tlsystems/H10-Paper-Tape-Reader-Punch/Heathkit H10 Info/H10 Manuals/H10 Parallel Connector.jpg

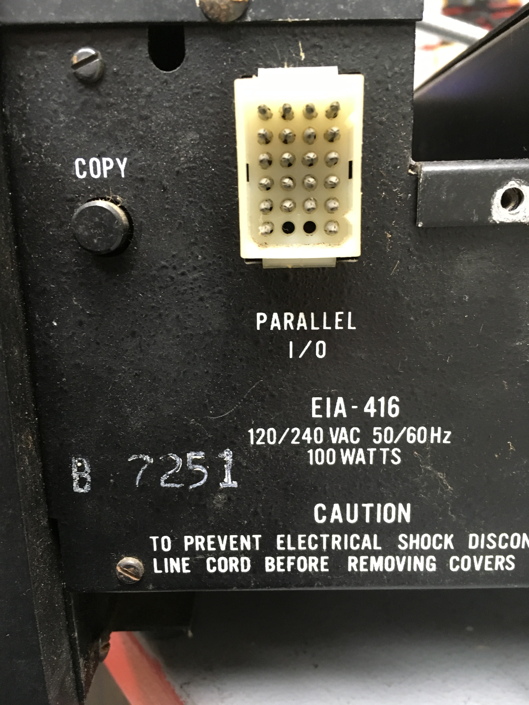
Heathkit H10 Info/H10 Manuals/H10 Parallel Connector.jpg
