tlsystems/H10-Paper-Tape-Reader-Punch/Heathkit H10 Info/H10 Manuals/H10 Schematic.pdf

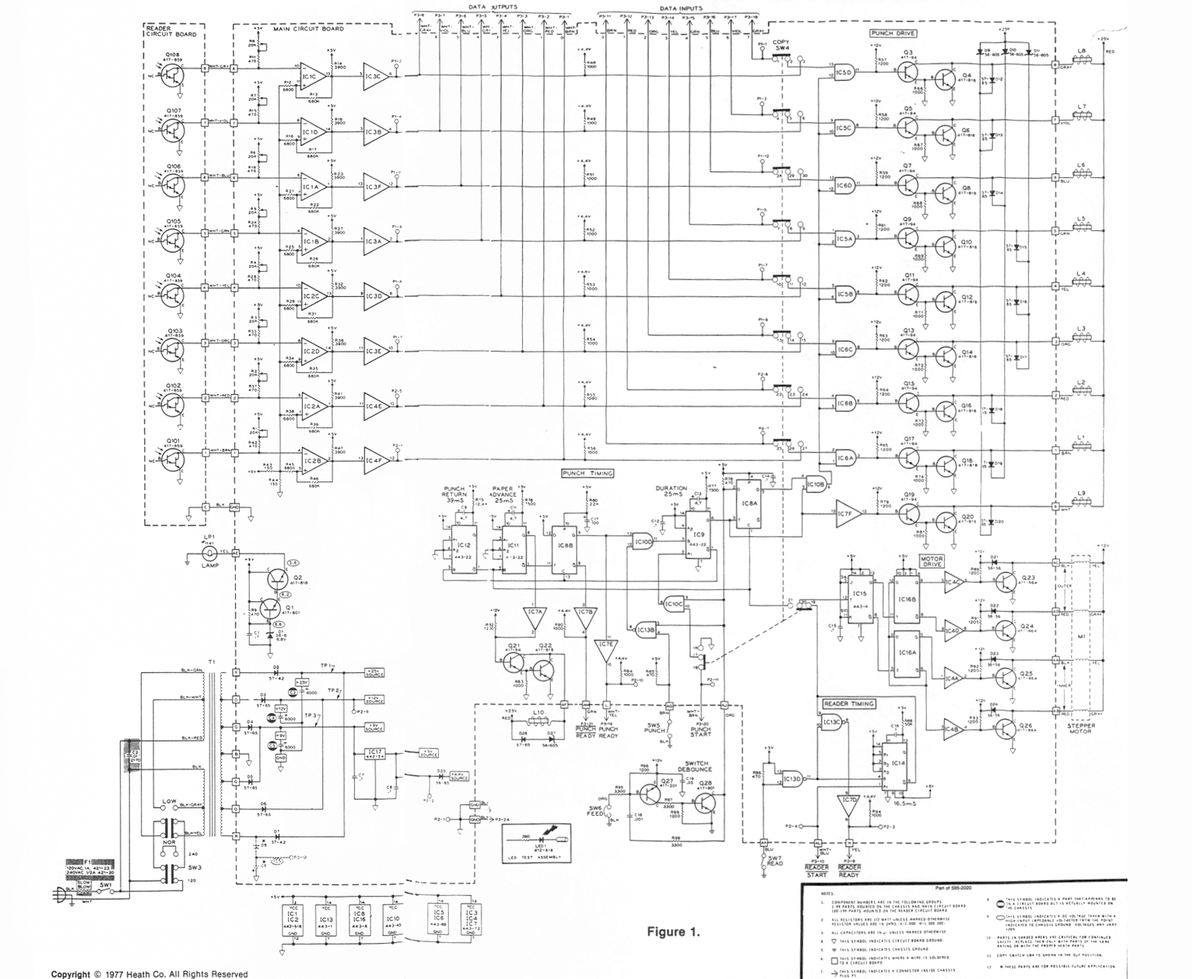
[picture p2: page 1]
