tlsystems/H10-Paper-Tape-Reader-Punch/H10 Info.xlsx

Sheet: Interface Specs
H10 Punch Inputs |  |  |  | 74HC595 Outputs @ 4.5V VCC |  | 74HCT595 Outputs @ 4.5V VCC
 | VIH | 2.0V min | <<<<< | VOH | 4.4V min | VOH | 3.98V min
 | VIL | 0.8V max | <<<<< | VOL | 0.33V max | VOL | 0.26V max
 | IIL | -1.6 mA | <<<<<
H10 Reader Outputs |  |  |  | SN74HC165 Inputs |  | SN74HCT165 Inputs |  |  | CD74HCT165 Inputs
 | VOH | 2.4V min | >>>>> | VIH | 3.15 min | VIH | 2.0V min | 1.6 typ | VIH | 2.0V min | 1.6 typ
 | VOL | 0.4V max | >>>>> | VIL | 1.35 max | VIL | 0.8V max | 1.2 typ | VIL | 0.8V max | 1.2 typ
 |  |  |  | IIL | 0.1uA | IIL | 1uA |  | IIL | 1uA
H10 Control Inputs
 | VIH | 2.0V min
 | VIL | 0.8V max
 | IIL | -1.6 mA
H10 Control Outputs
 | VOH† | +15V max
 | VOL | 0.4V max
 | IOL | 16mA
 | † | Open Collector w/1k pullup to 4.4V

Sheet: Commands
? | Help |  | Help Text | Return command help
EC | Echo | 0/1 | OK | Set serial port echo mode
PB | Punch Byt | 1 byte | OK | Punches on byte on H10
PT |  | String of characters | OK | Punches bitmapped text on the H10
PH |  | Intel hex record | OK | Punched data from an Intel Hex record
RB |  | <none> | 1 byte | Read one byte from the H10
RD |  | # bytes | Intel Hex Record | Reads 'n' bytes and returns them in a Intel Hex record

Sheet: CD vs. SN
SN74HCT165 Inputs |  |  | CD74HCT165 Inputs
VIH | 2.0V min | 1.6 typ | VIH | 2.0V min | 1.6 typ
VIL | 0.8V max | 1.2 typ | VIL | 0.8V max | 1.2 typ
IIL | 1uA |  | IIL | 1uA
VOH | 3.84V | 4mA | VOH | 3.98V | 4mA
VOL | 0.33V | 4mA | VOL | 0.33V | 4mA

Sheet: ICs
ICx | Type | Description
1 | LM2901 | Quad Differential Comparators
2 | LM2901 | Quad Differential Comparators
3 | SN74x17 | hex buffer gate w/open-collector
4 | SN74x17 | hex buffer gate w/open-collector
5 | SN74x09 | quad 2-input AND gate w/open-collector
6 | SN74x09 | quad 2-input AND gate w/open-collector
7 | SN74x17 | hex buffer gate w/open-collector
8 | SN74x74 | dual D positive edge triggered flip-flop, asynchronous preset and clear
9 | SN74x121 | monostable multivibrator w/Schmitt-trigger
10 | SN74x08 | quad 2-input AND gate
11 | SN74x121 | monostable multivibrator w/Schmitt-trigger
12 | SN74x121 | monostable multivibrator w/Schmitt-trigger
13 | SN74x00 | quad 2-input NAND gate
14 | 9600 | one-shot
15 | SN74x72 | AND gated J-K master-slave flip-flop, asynchronous preset and clear
16 | SN74x74 | dual D positive edge triggered flip-flop, asynchronous preset and clear

Sheet: TIming
PunchStart# | 200nS Min 80mS Max
PunchReady# | 200nS Max
PunchData
 |  | 25mSec Min
ReaderStart# | 100nS min
ReaderReady# | 200ns Max
Reader Data

Sheet: DB9
DB-9 RS-232 Wiring
 |  |  |  |  | View from front of connector
DB9-F | 10-pinFlat
1 | 1
2 | 3
3 | 5
4 | 7
5 | 9
6 | 2
7 | 4
8 | 6
9 | 8
 | 10
Out | DCD (1) | 1 | 2 | DSR (6) | Out
 | TxD (2) | 3 | 4 | CTS (7)
 | RxD (3) | 5 | 6 | RTS (8)
In | DTR (4) | 7 | 8 | RI (9) | Out |  |  | DB9-F | DB9-M
 | GND (5) | 9 | 10 | nc |  |  |  | DTE | DCE
 |  |  |  |  |  | 1 | DCD | In | Out | Data Carrier Detect
 |  |  |  |  |  | 2 | Rx | In | Out | Receive Data
 |  |  |  |  |  | 3 | Tx | Out | In | Transmit Data
 |  |  |  |  |  | 4 | DTR | Out | In | Data Terminal Ready
 |  |  |  |  |  | 5 | GND
 |  |  |  |  |  | 6 | DSR | In | Out | Data Set Ready
 |  |  |  |  |  | 7 | RTS | Out | In | Request To Send
 |  |  |  |  |  | 8 | CTS | In | Out | Clear To Send
 |  |  |  |  |  | 9 | RI | In | Out | Ring Indicator

Sheet: Transition Cable
H10 Transistion Cable Wiring
24-pin Molex to DB-25
 | P3 4x6 Molex | 2x13 Header | Color Internal | SW4 Pin | Function | Color | DB-25 | Wire # | Function | Color External | 24-Pin Molex |  |  |  | Wire | DB25 |  |  |  |  |  | SW4
 | 1 | 3 | Wh/Brn | 27 | RDO-0 | Grn | 1 | 1 | RDO-0 | Rd
 | 2 | 4 | Wh/Red | 24 | RDO-1 | Grn | 14 | 2 | RDO-1 | Wh/Bk/Rd |  |  |  |  | 1 | 1 | 1 |  |  | RD-0
 | 3 | 5 | Wh/Org | 15 | RDO-2 | Grn | 2 | 3 | RDO-2 | Wh/Gy |  |  |  |  | 2 |  |  | 14 | 2 | RD-1
 | 4 | 6 | Wh/Yel | 12 | RDO-3 | Grn | 15 | 4 | RDO-3 | Wh/Br |  |  |  |  | 3 | 3 | 2 |  |  | RD-2
 | 5 | 7 | Wh/Grn | 9 | RDO-4 | Grn | 3 | 5 | RDO-4 | Wh |  |  |  |  | 4 |  |  | 15 | 4 | RD-3 |  | Back
 | 6 | 8 | Wh/Blu | 30 | RDO-5 | Grn | 16 | 6 | RDO-5 | Gr | 4 | 3 | 2 | 1 | 5 | 5 | 3 |  |  | RD-4
 | 7 | 9 | Wh/Vio | 6 | RDO-6 | Grn | 4 | 7 | RDO-6 | Wh/Vi |  |  |  |  | 6 |  |  | 16 | 6 | RD-5 | 20 | Wh/Brn/Bk | 16 | 1 | Gry | 18
 | 8 | 10 | Wh/Gry | 3 | RDO-7 | Grn | 17 | 8 | RDO-7 | Rd/Yl | 8 | 7 | 6 | 5 | 7 | 7 | 4 |  |  | RD-6 |  |  | 17 | 2 | --7--
 | 9 | 21 | Yel | nc | ~ReaderReady | Blu | 10 | 19 | ~ReaderReady | Wh/Or |  |  |  |  | 8 |  |  | 17 | 8 | RD-7 |  |  | 18 | 3 | Wh/Gry | 8
 | 10 | 24 | Wh/Blu | nc | ~ReaderStart | Yel | 23 | 20 | ~ReaderStart | Gy | 12 | 11 | 10 | 9 | 9 | 22a | 5 |  |  | GND |  |  | 19 | 4 | Vio | 17
 | 11 | 12 | Brn | 25 | PDI-0 | Wh | 18 | 10 | PDI-0 | Gr/Rd |  |  |  |  | 10 |  |  | 18 | 11 | PD-0 |  |  | 20 | 5 | --6--
 | 12 | 13 | Red | 22 | PDI-1 | Wh | 6 | 11 | PDI-1 | Wh/Bl | 16 | 15 | 14 | 13 | 11 | 12 | 6 |  |  | PD-1 |  |  | 21 | 6 | Wh/Vio | 7
 | 13 | 14 | Org | 13 | PDI-2 | Wh | 19 | 12 | PDI-2 | Vi |  |  |  |  | 12 |  |  | 19 | 13 | PD-2 | 12 | Red | 22 | 7 | Grn | 15
 | 14 | 15 | Yel | 10 | PDI-3 | Wh | 7 | 13 | PDI-3 | Yl | 20 | 19 | 18 | 17 | 13 | 14 | 7 |  |  | PD-3 |  | --1-- | 23 | 8 | --4-
 | 15 | 16 | Grn | 7 | PDI-4 | Wh | 20 | 14 | PDI-4 | Wh/Bk |  |  |  |  | 14 |  |  | 20 | 15 | PD-4 | 2 | Wh/Red | 24 | 9 | Wh/Grn | 5
 | 16 | 17 | Blu | 28 | PDI-5 | Wh | 8 | 15 | PDI-5 | Wh/Rd | 24 | 23 | 22 | 21 | 15 | 16 | 8 |  |  | PD-5 | 11 | Brown | 25 | 10 | Yel | 14
 | 17 | 18 | Vio | 4 | PDI-6 | Wh | 21 | 16 | PDI-6 | Pk |  |  |  |  | 16 |  |  | 21 | 17 | PD-6 |  | --0-- | 26 | 11 | --3--
 | 18 | 19 | Gry | 1 | PDI-7 | Wh | 9 | 17 | PDI-7 | Bl |  |  |  |  | 17 | 18 | 9 |  |  | PD-7 | 1 | Wh/Brn | 27 | 12 | Wh/Yel | 4
 | 19 | NC | Grn | nc | PunchReady | Blu | 12 | 23 | ~PunchReady | Wh/Gr |  |  |  |  | 18 |  |  | 22 | 22b | GND | 16 | Blue | 28 | 13 | Org | 13
 | 20 | 25 | Wh/Brn/Blk | 16 | PunchStart | Yel | 24 | 22 | ~PunchStart | Tan |  |  |  |  | 19 | 9 | 10 |  |  | ~ReaderReady |  | --5-- | 29 | 14 | --2--
 | 21 | 22 | Wh/Brn/Blk | 16 | ~PunchReady | Yel | 24 | 22 | ~PunchStart | Tan |  |  |  |  | 20 |  |  | 23 | 10 | ~ReaderStart | 6 | Wh/Blu | 30 | 15 | Wh/Org | 3
 | 22 | 11 | Blk | nc | GND | Blk | 11,25 | 21,24 | GND |  |  |  |  |  | 21 | 24a | 11 |  |  | GND
 | 23 | 1 | Red (New) | nc | +9V | Red | 13 | 25 | +12V | Wh/Yl |  |  |  |  | 23 | 21 | 12 |  |  | ~PunchReady
 | 24 | 2 | Blk | nc | GND | Blk | 11,25 | 21,24 | GND |  |  |  |  |  | 25 | 23a | 13 |  |  | +12V
 |  | 20 | Blk | nc | GND | Blk | 11,25 | 21,24 | GND |  |  |  |  |  | 25 | 23a | 13 |  |  | +12V | 9 | Yellow
 |  | 23 | Blk (New) | nc | GND | Blk | 5,22 | 9,18 | GND | Or |  |  |  |  | 26 |  |  |  |  | N/C | 10 | White/Blue
 |  | 26 | NC |  |  |  |  |  |  |  |  |  |  |  |  |  |  |  |  |  | 19 | White/Yello
 |  |  |  |  |  |  |  |  |  |  |  |  |  |  |  |  |  |  |  |  | 21 | Green
 |  |  |  |  |  |  |  |  |  |  |  |  |  |  |  |  |  |  |  |  | 22 | BK
 |  |  |  |  |  |  |  |  |  |  |  |  |  |  |  |  |  |  |  |  | 23 | RD
 | 21 |  | Wh/Yel | nc | PunchReady |  |  |  |  | Rd/Bk |  |  |  |  |  |  |  |  |  |  | 24 | BK
 | 1 |  | +12V
 | 2 |  | GND |  |  |  |  | 1 | White/Brown
 | 3 |  | RD0 | Output |  |  |  | 2 | White/Red
 | 4 |  | RD1 | Output |  |  |  | 3 | Whitw/Orange
 | 5 |  | RD2 | Output |  |  |  | 4 | White/Yellow
 | 6 |  | RD3 | Output |  |  |  | 5 | White/Green
 | 7 |  | RD4 | Output |  |  |  | 6 | White/Blue
 | 8 |  | RD5 | Output |  |  |  | 7 | White/Purple
 | 9 |  | RD6 | Output |  |  |  | 8 | White/Grey
 | 10 |  | RD7 | Output |  |  |  | 9 | Yellow
 | 11 |  | GND |  |  |  |  | 10 | White/Blue
 | 12 |  | PD0 | Input |  |  |  | 11 | Brown
 | 13 |  | PD1 | Input |  |  |  | 12 | Red
 | 14 |  | PD2 | Input |  |  |  | 13 | Orange
 | 15 |  | PD3 | Input |  |  |  | 14 | Yellow
 | 16 |  | PD4 | Input |  |  |  | 15 | Green
 | 17 |  | PD5 | Input |  |  |  | 16 | Blue
 | 18 |  | PD6 | Input |  |  |  | 17 | Purple
 | 19 |  | PD7 | Input |  |  |  | 18 | Grey
 | 20 |  | GND |  |  |  |  | 19 | White/Yellow
 | 21 |  | ReaderReady# | Output |  |  |  | 20 | White/Browh
 | 22 |  | PunchReady# | Output |  |  |  | 21 | Green
 | 23 |  | GND |  |  |  |  | 22 | Black
 | 24 |  | ReaderStart# | Input |  |  |  | 23 | Red
 | 25 |  | PunchStart# | Input |  |  |  | 24 | Black
 | 26
 | DB-25 | Cable | Name | Color
 | 1 | 1 | RDO-0 | Gn
 | 14 | 2 | RDO-1 | Gn
 | 2 | 3 | RDO-2 | Gn
 | 15 | 4 | RDO-3 | Gn
 | 3 | 5 | RDO-4 | Gn
 | 16 | 6 | RDO-5 | Gn
 | 4 | 7 | RDO-6 | Gn
 | 17 | 8 | RDO-7 | Gn
 | 5 | 9 | GND | Bk
 | 18 | 10 | PDI-0 | Wh
 | 6 | 11 | PDI-1 | Wh
 | 19 | 12 | PDI-2 | Wh
 | 7 | 13 | PDI-3 | Wh
 | 20 | 14 | PDI-4 | Wh
 | 8 | 15 | PDI-5 | Wh
 | 21 | 16 | PDI-6 | Wh
 | 9 | 17 | PDI-7 | Wh
 | 22 | 18 | GND | Bk
 | 10 | 19 | ~ReaderReady | Bl
 | 23 | 20 | ~ReaderStart | Yl
 | 11 | 21 | GND | Bk
 | 24 | 22 | ~PunchStart | Yl
 | 12 | 23 | ~PunchReady | Bl
 | 25 | 24 | GND | Bk
 | 13 | 25 | +12V | Rd
 | NC | 26

Sheet: Shield Wiring
 | V 0.3 | Wiz Shield | V 0.4 |  |  |  |  |  |  |  | Teensy 4.0 | Teensy 4.1
SCK
SDA
GND
AREF
D13
D12 |  |  | PunchStart |  | GND | 1
D11 | PunchStart |  | PunchReady | ISCP GND | GND | 2 | 1 | 3V3D | 3V3 | CS | 10 | 10
D10 | PunchReady | CSn |  | ISCP MOSI | MOSI | 3 | 2 | RDY | D2 | MOSI | 11 | 11
D9 | ReaderReady |  | ReaderReady | ISCP MISO | MISO | 4 | 3 | RSTn | D3 | MISO | 12 | 12
D8 | ReaderStart |  | ReaderStart | ISCP SCLK | SCLK | 5 | 4 | NC |  | SCK | 13 | 13
D7 | ReadDataLoad |  | ReadDataLoad | D10 | SCSn | 6 | 5 | INTn | D5 | RDY |  | 31
D6 | PunchDataLatch |  | PunchDataLatch |  | 3V3D | 7 | 6 | GND | GND | RSTn |  | 30
D5 |  | INTn (2-7) |  |  | 3V3D | 8 |  |  |  | INTn | 5 | 29
D4 |  | SD_SSn (8-10) |  |  |  |  |  |  |  | SC_SSn | 4 | 33
D3 | CTS |  | CTS
D2 | RTS |  | RTS |  |  |  |  |  |  | LED1
D1 | Tx |  | Tx |  | GND | 6 | 5 | RESET
D0 | Rx |  | Rx |  | MOSI | 4 | 3 | SCK | RD
 |  |  |  |  | 5V | 2 | 1 | MISO | OR
ICSP-GND | GND | GND | GND
ICSP-Vcc | Vcc | Vcc | Vcc
ICSP-RSTn
ICSP-SCK | SCK | SCK | SCK |  |  |  |  |  |  | SCK | 13
ISCP-MOSI | MOSI | MOSI | MOSI |  |  |  |  |  |  | MOSI | 11
ISCP-MISO | MISO | MISO | MISO |  |  |  |  |  |  | MISO | 12
A0 | LED1 |  | LED1
A1 | LED2 |  | LED2
A2
A3
A4
A5
A6
 | W5100 | W5200 | W5500
 |  | writeMR(0x08) | writeMR(0x08)
 |  | writeMR(0x10) | writeMR(0x10)
 |  | writeMR(0x00) | writeMR(0x00)
 |  | Version = 3 | Version = 4

Sheet: Sheet2
 |  |  |  |  |  |  | Row
 | 0x00 | 0x00 | 0x5f | 0x00 | 0x00 |  | 7 | 6 | 5 | 4 | 3 | 2 | 1 | 0
 |  |  |  |  |  | Col 0 |  | . | . | . | . | . | . | . | 0x00 |  | 0,0- | 0,0
00000000 | row0 | 0x00 |  |  |  | Col 1 |  | . | . | . | . | . | . | . | 0x00 |  | 0,1 | 1,0
00000000 | row1 | 0x04 |  |  |  | Col 2 |  | x |  | x | x | x | x | x | 0x5f |  | 0,2 | 2,0
01011111 | row2 | 0x00 |  |  |  | Col 3 |  | . | . | . | . | . | . | . | 0x00 |  | 0,3 | 3,0
00000000 | row3 | 0x04 |  |  |  | Col 4 |  | . | . | . | . | . | . | . | 0x00 |  | 0,4 | 4,0
00000000 | row4 | 0x04 |  |  |  | Col 5
 | row5 | 0x04 |  |  |  | Col 6
 | row6 | 0x04 |  |  |  | Col 7 |  |  |  |  |  |  |  |  |  |  | 2,0 | 0,2
 | row7 | 0x04 |  |  |  |  |  |  |  |  |  |  |  |  |  |  | 2,1 | 1,2
 |  |  |  |  |  |  | Col |  |  |  |  |  |  |  |  |  | 2,2 | 2,2
 |  |  |  |  |  |  | 7 | 6 | 5 | 4 | 3 | 2 | 1 | 0 |  |  | 2,3 | 3,2
 |  |  |  |  |  | Row 0 |  |  |  | . | . | x | . | . | 0x04 |  | 2,4 | 4,2
 |  |  |  |  |  | Row 1 |  |  |  | . | . | x | . | . | 0x04 |  | 2,5 | 5,2
 |  |  |  |  |  | Row 2 |  |  |  | . | . | x | . | . | 0x04 |  | 2,6 | 6,2
 |  |  |  |  |  | Row 3 |  |  |  | . | . | x | . | . | 0x04 |  | 2,7 | 7,2
 |  |  |  |  |  | Row 4 |  |  |  | . | . | x | . | . | 0x04
 |  |  |  |  |  | Row 5 |  |  |  | . | . | . | . | . | 0x04
 |  |  |  |  |  | Row 6 |  |  |  | . | . | x | . | . | 0x04
 |  |  |  |  |  | Row 7
 |  |  |  |  |  |  | 0 | 1 | 2 | 3 | 4 | 5 | 6 | 7
 |  |  |  |  |  | Col 0 | . | . | x | . | . |  |  |  | 0x04
 |  |  |  |  |  | Col 1 | . | x | x | . | . |  |  |  | 0x06
 |  |  |  |  |  | Col 2 | . | . | x | . | . |  |  |  | 0x04
 |  |  |  |  |  | Col 3 | . | . | x | . | . |  |  |  | 0x04
 |  |  |  |  |  | Col 4 | . | . | x | . | . |  |  |  | 0x04
 |  |  |  |  |  | Col 5 | . | . | x | . | . |  |  |  | 0x04
 |  |  |  |  |  | Col 6 | . | x | x | x | . |  |  |  | 0x0e
 |  |  |  |  |  | Col 7
 |  |  |  |  |  |  | Col
 |  |  |  |  |  |  | 0 | 1 | 2 | 3 | 4 | 5 | 6 | 7 |  | 0,0 | 0,0
 |  |  |  |  |  | Row 0 | . | . | . | . | . | . | . |  | 0x04 | 0,1 | 1,0
 |  |  |  |  |  | Row 1 | . | x | . | . | . | . | x |  | 0x04 | 0,2 | 2,0
 |  |  |  |  |  | Row 2 | x | x | x | x | x | x | x |  | 0x04
 |  |  |  |  |  | Row 3 | . | . | . | . | . | . | x |  | 0x04
 |  |  |  |  |  | Row 4 | . | . | . | . | . | . | . |  | 0x04
 |  |  |  |  |  | Row 5 |  |  |  |  |  |  |  |  | 0x04
 |  |  |  |  |  | Row 6 |  |  |  |  |  |  |  |  | 0x04
 |  |  |  |  |  | Row 7
 |  |  |  | a5 | 10100101

Sheet: Sheet3
 |  |  |  |  |  |  |  | 48 | $J$52 | $K$52 | $L$52 | $M$52 | $N$52 | $O$52
 |  |  |  |  |  |  |  |  | 00000000 | 00111110 | 01010001 | 01001001 | 01000101 | 00111110
 |  |  |  |  |  |  |  |  | Col 0 | Col 1 | Col 2 | Col 3 | Col 4 | Col 5 |  |  |  |  |  |  | byte [][] CharMap = {
0 | 0x0 | # | 0x00 | 0x00 | 0x00 | 0x00 | 0x00 | NUL | 0 | 0 | 0 | 0 | 0 | 0 | 8 |  | . | . | . |  | {0x00,0x00,0x00,0x00,0x00}, // 0x0 '#'
1 | 0x1 | SOH | 0x00 | 0x00 | 0x00 | 0x00 | 0x00 | Smile | 0 | 0 | 0 | 0 | 0 | 0 | 7 | . |  |  |  | . | {0x00,0x00,0x00,0x00,0x00}, // 0x1 'SOH'
2 | 0x2 | STC | 0x00 | 0x00 | 0x00 | 0x00 | 0x00 | Smile | 0 | 0 | 0 | 0 | 0 | 0 | 6 | . |  |  | . | . | {0x00,0x00,0x00,0x00,0x00}, // 0x2 'STC'
3 | 0x3 | ETX | 0x00 | 0x00 | 0x00 | 0x00 | 0x00 | Heart | 0 | 0 | 0 | 0 | 0 | 0 | 5 | . |  | . |  | . | {0x00,0x00,0x00,0x00,0x00}, // 0x3 'ETX'
4 | 0x4 | EOT | 0x00 | 0x00 | 0x00 | 0x00 | 0x00 | Diamond | 0 | 0 | 0 | 0 | 0 | 0 | 4 | . | . |  |  | . | {0x00,0x00,0x00,0x00,0x00}, // 0x4 'EOT'
5 | 0x5 | ENQ | 0x00 | 0x00 | 0x00 | 0x00 | 0x00 | Club | 0 | 0 | 0 | 0 | 0 | 0 | 3 | . |  |  |  | . | {0x00,0x00,0x00,0x00,0x00}, // 0x5 'ENQ'
6 | 0x6 | ACK | 0x00 | 0x00 | 0x00 | 0x00 | 0x00 | Spade | 0 | 0 | 0 | 0 | 0 | 0 | 2 |  | . | . | . |  | {0x00,0x00,0x00,0x00,0x00}, // 0x6 'ACK'
7 | 0x7 | BEL | 0x00 | 0x00 | 0x00 | 0x00 | 0x00 | Bullet1 | 0 | 0 | 0 | 0 | 0 | 0 | 1 |  |  |  |  |  | {0x00,0x00,0x00,0x00,0x00}, // 0x7 'BEL'
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
127 | 0x7F |  | 0x7f | 0x6b | 0x6b | 0x6b | 0x7f |  | 0 | 1111111 | 1101011 | 1101011 | 1101011 | 1111111 |  |  |  |  |  |  | {0x7f,0x6b,0x6b,0x6b,0x7f}, // 0x7F ' '
 |  |  |  |  |  |  |  |  |  |  |  |  |  |  |  |  |  |  |  |  | };
