tlsystems/H10-Paper-Tape-Reader-Punch/Kicad/H10 Pi Pico/H10 Pico Info.xlsx

Sheet: RedBoard T
seq | Connector | Function | Signal | Pin | Pin Function | Dir | I/O Pin | Supply | EIC | REF | ADC | AC | PTC | DAC | SER | ALT | TC/TCC | TCC | COM | AC/GCLK | Other
 |  | Reset | RESET~
 | J1-1 | Power Battery | VBAT
 | J1-2 | Power | GND
 | J2-1 | Power | GND
 | J2-2 | Power | VCC
38 | J2-3 | QWIIC | SDA | 31 | SERCOM3:1 |  | PA22 | VDDIO | EXTINT[6] |  |  |  | X[10] |  | SERCOM3:0 | SERCOM5:0 | TC4:0 | TCC0:4 |  | GCLK_IO[6]
38 | J2-4 | QWIIC | SCL | 32 | SERCOM3:0 |  | PA23 | VDDIO | EXTINT[7] |  |  |  | X[11] |  | SERCOM3:1 | SERCOM5:1 | TC4:1 | TCC0:5 | USB/SOF 1kHz | GCLK_IO[7]
 | J3-1 | VBUS | VUSB
39 | J3-2 | D- | USB_D- | 33 | USB_DM |  | PA24(6) | VDDIO | EXTINT[12] |  |  |  |  |  | SERCOM3:2 | SERCOM5:2 | TC5:0 | TCC1:2 | USB/DM
40 | J3-3 | D+ | USB_D+ | 34 | USB_DP |  | PA25(6) | VDDIO | EXTINT[13] |  |  |  |  |  | SERCOM3:3 | SERCOM5:3 | TC5:1 | TCC1:3 | USB/DP
 | J3-4 | ID | USB_ID
 | J3-5 | GND | GND
 | J3-6 | SHIELD | SHIELD
 | JP1-Sleeve | Power External | GND
 | JP1-Tip | Power External | ExtPower
 | JP6-01 | VCC | 3V3
 | JP6-02 | SWDIO/TMD | RX_LED/SWDIO
 | JP6-03 | GND | GND
 | JP6-04 | SWDCLK/TCK | LED/SWCLK
 | JP6-05 | GND | GND
 | JP6-06 | SWO/TDO | NC
 | JP6-07 | KEY | NC
 | JP6-08 | NC/TDI | NC
 | JP6-09 | GNDDTCT | NC
 | JP6-10 | NRESET | RESET~
 | TP1 |  | RX_LED/SWDIO
 | Shld1-01 | IO QWIIC | SCL | 32 | SERCOM3:1 |  | PA23 | VDDIO | EXTINT[7] |  |  |  | X[11] |  | SERCOM3:1 | SERCOM5:1 | TC4:1 | TCC0:5 | USB/SOF 1kHz | GCLK_IO[7]
 | Shld1-02 | IO QWIIC | SDA | 31 | SERCOM3:0 |  | PA22 | VDDIO | EXTINT[6] |  |  |  | X[10] |  | SERCOM3:0 | SERCOM5:0 | TC4:0 | TCC0:4 |  | GCLK_IO[6]
8 | Shld1-03 | IO Analog | AREF | 4 | ADC/VREFA/DAC/VREFA |  | PA03 | VDDANA | EXTINT[3] | ADC/VREFA/DAC/VREFA | AIN[1] |  | Y[1] |  |  |  |  | TCC3:1
 | Shld1-04 | Power | GND
32 | Shld1-05 | IO Digital | D13 ~ | 26 | PA17 | DIO | PA17 | VDDIO | EXTINT[1] |  |  |  | X[5] |  | SERCOM1:1 | SERCOM3:1 | TCC2:1 | TCC0:7 |  | GCLK_IO[3]
34 | Shld1-06 | IO Digital | D12 ~ | 28 | PA19 | DIO | PA19 | VDDIO | EXTINT[3] |  |  |  | X[7] |  | SERCOM1:3 | SERCOM3:3 | TC3:1 | TCC0:3 | I2S/SD[0] | AC/CMP[1]
31 | Shld1-07 | IO Digital | D11 ~ | 25 | PA16 | DIO | PA16 | VDDIO | EXTINT[0] |  |  |  | X[4] |  | SERCOM1:0 | SERCOM3:0 | TCC2:0 | TCC0:6 |  | GCLK_IO[2]
33 | Shld1-08 | IO Digital | D10 ~ | 27 | PA18 | DIO | PA18 | VDDIO | EXTINT[2] |  |  |  | X[6] |  | SERCOM1:2 | SERCOM3:2 | TC3:0 | TCC0:2 |  | AC/CMP[0]
12 | Shld1-09 | IO Digital | D9 ~ | 12 | PA07 | DIO | PA07 | VDDANA | EXTINT[7] |  | AIN[7] | AIN[3] | Y[5] |  |  | SERCOM0:3 | TCC1:1 | TCC3:5 | I2S/SD[0]
11 | Shld1-10 | IO Digital | D8 ~ | 11 | PA06 | DIO | PA06 | VDDANA | EXTINT[6] |  | AIN[6] | AIN[2] | Y[4] |  |  | SERCOM0:2 | TCC1:0 | TCC3:4
36 | Shld2-1 | IO Digital | D7 | 30 | PA21 | DIO | PA21 | VDDIO | EXTINT[5] |  |  |  | X[9] |  | SERCOM5:3 | SERCOM3:3 | TC7:1 | TCC0:7 | I2S/FS[0] | GCLK_IO[5]
35 | Shld2-2 | IO Digital | D6 ~ | 29 | PA20 | DIO | PA20 | VDDIO | EXTINT[4] |  |  |  | X[8] |  | SERCOM5:2 | SERCOM3:2 | TC7:0 | TCC0:6 | I2S/SCK[0] | GCLK_IO[4]
30 | Shld2-3 | IO Digital | D5 ~ | 24 | PA15 | DIO | PA15 | VDDIO | EXTINT[15] |  |  |  |  |  | SERCOM2:3 | SERCOM4:3 | TC3:1 | TCC0:5 |  | GCLK_IO[1]
23 | Shld2-4 | IO Digital | D4 ~ | 13 | PA08 | DIO | PA08 | VDDIO | NMI |  | AIN[16] |  | X[0] |  | SERCOM0:0 | SERCOM2:0 | TCC0:0 | TCC1:2 | I2S/SD[1]
24 | Shld2-5 | IO Digital | D3 ~ | 14 | PA09 | DIO | PA09 | VDDIO | EXTINT[9] |  | AIN[17] |  | X[1] |  | SERCOM0:1 | SERCOM2:1 | TCC0:1 | TCC1:3 | I2S/MCK[0]
29 | Shld2-6 | IO Digital | D2 | 23 | PA14 | DIO | PA14 | VDDIO | EXTINT[14] |  |  |  |  |  | SERCOM2:2 | SERCOM4:2 | TC3:0 | TCC0:4 |  | GCLK_IO[0]
25 | Shld2-7 | IO Digital | D1/TX0 | 15 | PA10,SER0:2 |  | PA10 | VDDIO | EXTINT[10] |  | AIN[18] |  | X[2] |  | SERCOM0:2 | SERCOM2:2 | TCC1:0 | TCC0:2 | I2S/SCK[0] | GCLK_IO[4]
26 | Shld2-8 | IO Digital | DO/RXI | 16 | PA11,SER0:3 |  | PA11 | VDDIO | EXTINT[11] |  | AIN[19] |  | X[3] |  | SERCOM0:3 | SERCOM2:3 | TCC1:1 | TCC0:3 | I2S/FS[0] | GCLK_IO[5]
7 | Shld3-1 | IO Analog | A0/DAC | 3 | AIN[0], PA02, VOUT | AIN, DIO, AOUT | PA02 | VDDANA | EXTINT[2] |  | AIN[0] |  | Y[0] | VOUT |  |  |  | TCC3:0
15 | Shld3-2 | IO Analog | A1 | 7 | AIN[2], PA08 | AIN, DIO | PB08 | VDDANA | EXTINT[8] |  | AIN[2] |  | Y[14] |  |  | SERCOM4:0 | TC4:0 | TCC3:6
16 | Shld3-3 | IO Analog | A2 | 8 | AIN[3], PA09 | AIN, DIO | PB09 | VDDANA | EXTINT[9] |  | AIN[3] |  | Y[15] |  |  | SERCOM4:1 | TC4:1 | TCC3:7
9 | Shld3-4 | IO Analog | A3 | 9 | AIN[4], PA04 | AIN, DIO | PA04 | VDDANA | EXTINT[4] | ADC/VREFB | AIN[4] | AIN[0] | Y[2] |  |  | SERCOM0:0 | TCC0:0 | TCC3:2
10 | Shld3-5 | IO Analog | A4 | 10 | AIN[5], PA05 | AIN, DIO | PA05 | VDDANA | EXTINT[5] |  | AIN[5] | AIN[1] | Y[3] |  |  | SERCOM0:1 | TCC0:1 | TCC3:3
13 | Shld3-6 | IO Analog | A5 | 47 | AIN[10], PB02 | AIN, DIO | PB02 | VDDANA | EXTINT[2] |  | AIN[10] |  | Y[8] |  |  | SERCOM5:0 | TC6:0 | TCC3:2
 | Shld4-1 |  | REF
 | Shld4-2 | Power | 3V3
 | Shld4-3 | Power | 5V
 | Shld4-4 | Power | GND
 | Shld4-5 | Power | GND
 | Shld4-6 | Power External | VIN
1 |  |  | ???? | 40 | RESET~ |  | RESET~
2 |  |  | 3V3 | 44 | Power |  | VDDIN
3 |  |  | Bypass | 43 | Power |  | VDDCORE
4 |  |  | Filter | 6 | Power |  | VDDANA
5 |  | RTC | RTC XTAL | 1 | XIN32 |  | PA00 | VDDANA | EXTINT[0] |  |  |  |  |  |  | SERCOM1:0 | TCC2:0 |  |  |  | XIN32
6 |  | RTC | RTC XTAL | 2 | XOUT32 |  | PA01 | VDDANA | EXTINT[1] |  |  |  |  |  |  | SERCOM1:1 | TCC2:1 |  |  |  | XOUT32
14 |  | Flash Memory | FLASH_MISO | 48 | SERCOM5:1 |  | PB03 | VDDANA | EXTINT[3] |  | AIN[11] |  | Y[9] |  |  | SERCOM5:1 | TC6:1 | TCC3:3
17 |  |  | GND | 5 | Power |  | GNDANA
18 |  |  | GND | 18 | Power |  | GND
19 |  |  | GND | 35 | Power |  | GND
20 |  |  | GND | 42 | Power |  | GND
21 |  |  | 3V3 | 17 | Power |  | VDDIO
22 |  |  | 3V3 | 36 | Power |  | VDDIO
27 |  | SPI | SPI_MISO | 21 | SER4:0 |  | PA12 | VDDIO | EXTINT[12] |  |  |  |  |  | SERCOM2:0 | SERCOM4:0 | TCC2:0 | TCC0:6 |  | AC/CMP[0]
28 |  | Flash Memory | FLASH_CS | 22 | PA13 |  | PA13 | VDDIO | EXTINT[13] |  |  |  |  |  | SERCOM2:1 | SERCOM4:1 | TCC2:1 | TCC0:7 |  | AC/CMP[1]
41 |  | Serial Tx | TX_LED | 39 | PA27 | DOUT | PA27 | VDDIO | EXTINT[15] |  |  |  |  |  |  |  | TCC3:6 |  |  | GCLK_IO[0]
42 |  | USB | USB_HOST_EN | 41 | PA28 | DOUT | PA28 | VDDIO | EXTINT[8] |  |  |  |  |  |  |  | TCC3:7 |  |  | GCLK_IO[0]
43 |  |  | LED/SWCLK | 45 | PA30 | DOUT | PA30 | VDDIO | EXTINT[10] |  |  |  |  |  |  | SERCOM1:2 | TCC1:0 | TCC3:4 | SWCLK | GCLK_IO[0]
44 |  | Serial Rx | RX_LED/SWDIO | 46 | PA31 | DOUT | PA31 | VDDIO | EXTINT[11] |  |  |  |  |  |  | SERCOM1:3 | TCC1:1 | TCC3:5 | SWDIO(5)
45 |  | SPI | SPI_MOSI | 19 | SER4:2 |  | PB10 | VDDIO | EXTINT[10] |  |  |  |  |  |  | SERCOM4:2 | TC5:0 | TCC0:4 | I2S/MCK[1] | GCLK_IO[4]
46 |  | SPI | SPI_SCK | 20 | SER4:3 |  | PB11 | VDDIO | EXTINT[11] |  |  |  |  |  |  | SERCOM4:3 | TC5:1 | TCC0:5 | I2S/SCK[1] | GCLK_IO[5]
47 |  | Flash Memory | FLASH_MOSI | 37 | SERCOM5:2 |  | PB22 | VDDIO | EXTINT[6] |  |  |  |  |  |  | SERCOM5:2 | TC7:0 | TCC3:0 |  | GCLK_IO[0]
48 |  | Flash Memory | FLASH_SCK | 38 | SERCOM5:3 |  | PB23 | VDDIO | EXTINT[7] |  |  |  |  |  |  | SERCOM5:3 | TC7:1 | TCC3:1 |  | GCLK_IO[1]
 |  | Charge Sts | CHG_STAT
 |  | Blue LED | D13
 |  | Green LED | TX_LED
 |  | Yellow LED | RX_LED/SWDIO
 | JP7 | A0 | A0
 | JP7 | A1 | A1
 | JP7 | A2 | A2
 | JP7 | A3 | A3
 | JP7 | A4 | A4
 | JP7 | A5 | A5
 | JP7 | IOREF | 3V3
 | JP7 | RESET# | RESET#
 | JP7 | VIN | VIN
 | JP7 | 5V | VUSB
 | JP7 | 3V3 | 3V3
 | JP7 | AREF | AREF
 | JP7 | GND | GND
 | JP7 | GND | GND
 | JP7 | GND | GND
 | JP7 | VCC | 3V3
 | JP7 | MISO | MISO
 | JP7 | MOSI | MOSI
 | JP7 | SCK | SCK
 | JP7 | RESET# | RESET#
 | JP7 | GND | GND
 | JP7 | D0 | D0/RXI
 | JP7 | D1 | D1/TXO
 | JP7 | D2 | D2
 | JP7 | D3 | D3
 | JP7 | D4 | D4
 | JP7 | D5 | D5
 | JP7 | D6 | D6
 | JP7 | D7 | D7
 | JP7 | D8 | D8
 | JP7 | D9 | D9
 | JP7 | D10 | D10
 | JP7 | D11 | D11
 | JP7 | D12 | D12
 | JP7 | D13 | D13
 | JP7 | SDA | SDA
 | JP7 | SCL | SCK
 |  | D7-VDD | 3V3
 |  | D7-DI | LED/SWCLK
 |  | D7-DO | NC
 |  | D7-VSS | GND
 | Flash-1 | CS~ | FLASH_CS
 | Flash-2 | SO | FLASH_MISO
 | Flash-3 | WP~ | 3V3
 | Flash-4 | GND | GND
 | Flash-5 | SI | FLASH_MOSI
 | Flash-6 | SCK | FLASH_SCK
 | Flash-7 | HOLD~ | 3V3
 | Flash-8 | VCC | 3V3
 | S1 | Reset | RESET~
 | JP3-Tip | Power | VIN
 | JP3_Sleeve | Ground | GND

Sheet: ATSAMD21G18
Pin | I/O Pin | Supply | EIC | REF | ADC | AC | PTC | DAC | SERCOM | ALT | TC/TCC | TCC | COM | AC/GCLK
1 | PA00 | VDDANA | EXTINT[0] |  |  |  |  |  |  | SERCOM1:0 | TCC2:0
2 | PA01 | VDDANA | EXTINT[1] |  |  |  |  |  |  | SERCOM1:1 | TCC2:1
3 | PA02 | VDDANA | EXTINT[2] |  | AIN[0] |  | Y[0] | VOUT |  |  |  | TCC3:0
4 | PA03 | VDDANA | EXTINT[3] | ADC/VREFA/DAC/VREFA | AIN[1] |  | Y[1] |  |  |  |  | TCC3:1
5 | GNDANA
6 | VDDANA
7 | PB08 | VDDANA | EXTINT[8] |  | AIN[2] |  | Y[14] |  |  | SERCOM4:0 | TC4:0 | TCC3:6
8 | PB09 | VDDANA | EXTINT[9] |  | AIN[3] |  | Y[15] |  |  | SERCOM4:1 | TC4:1 | TCC3:7
9 | PA04 | VDDANA | EXTINT[4] | ADC/VREFB | AIN[4] | AIN[0] | Y[2] |  |  | SERCOM0:0 | TCC0:0 | TCC3:2
10 | PA05 | VDDANA | EXTINT[5] |  | AIN[5] | AIN[1] | Y[3] |  |  | SERCOM0:1 | TCC0:1 | TCC3:3
11 | PA06 | VDDANA | EXTINT[6] |  | AIN[6] | AIN[2] | Y[4] |  |  | SERCOM0:2 | TCC1:0 | TCC3:4
12 | PA07 | VDDANA | EXTINT[7] |  | AIN[7] | AIN[3] | Y[5] |  |  | SERCOM0:3 | TCC1:1 | TCC3:5 | I2S/SD[0]
13 | PA08 | VDDIO | NMI |  | AIN[16] |  | X[0] |  | SERCOM0:0 | SERCOM2:0 | TCC0:0 | TCC1:2 | I2S/SD[1]
14 | PA09 | VDDIO | EXTINT[9] |  | AIN[17] |  | X[1] |  | SERCOM0:1 | SERCOM2:1 | TCC0:1 | TCC1:3 | I2S/MCK[0]
15 | PA10 | VDDIO | EXTINT[10] |  | AIN[18] |  | X[2] |  | SERCOM0:2 | SERCOM2:2 | TCC1:0 | TCC0:2 | I2S/SCK[0] | GCLK_IO[4]
16 | PA11 | VDDIO | EXTINT[11] |  | AIN[19] |  | X[3] |  | SERCOM0:3 | SERCOM2:3 | TCC1:1 | TCC0:3 | I2S/FS[0] | GCLK_IO[5]
17 | VDDIO
18 | GND
19 | PB10 | VDDIO | EXTINT[10] |  |  |  |  |  |  | SERCOM4:2 | TC5:0 | TCC0:4 | I2S/MCK[1] | GCLK_IO[4]
20 | PB11 | VDDIO | EXTINT[11] |  |  |  |  |  |  | SERCOM4:3 | TC5:1 | TCC0:5 | I2S/SCK[1] | GCLK_IO[5]
21 | PA12 | VDDIO | EXTINT[12] |  |  |  |  |  | SERCOM2:0 | SERCOM4:0 | TCC2:0 | TCC0:6 |  | AC/CMP[0]
22 | PA13 | VDDIO | EXTINT[13] |  |  |  |  |  | SERCOM2:1 | SERCOM4:1 | TCC2:1 | TCC0:7 |  | AC/CMP[1]
23 | PA14 | VDDIO | EXTINT[14] |  |  |  |  |  | SERCOM2:2 | SERCOM4:2 | TC3:0 | TCC0:4 |  | GCLK_IO[0]
24 | PA15 | VDDIO | EXTINT[15] |  |  |  |  |  | SERCOM2:3 | SERCOM4:3 | TC3:1 | TCC0:5 |  | GCLK_IO[1]
25 | PA16 | VDDIO | EXTINT[0] |  |  |  | X[4] |  | SERCOM1:0 | SERCOM3:0 | TCC2:0 | TCC0:6 |  | GCLK_IO[2]
26 | PA17 | VDDIO | EXTINT[1] |  |  |  | X[5] |  | SERCOM1:1 | SERCOM3:1 | TCC2:1 | TCC0:7 |  | GCLK_IO[3]
27 | PA18 | VDDIO | EXTINT[2] |  |  |  | X[6] |  | SERCOM1:2 | SERCOM3:2 | TC3:0 | TCC0:2 |  | AC/CMP[0]
28 | PA19 | VDDIO | EXTINT[3] |  |  |  | X[7] |  | SERCOM1:3 | SERCOM3:3 | TC3:1 | TCC0:3 | I2S/SD[0] | AC/CMP[1]
29 | PA20 | VDDIO | EXTINT[4] |  |  |  | X[8] |  | SERCOM5:2 | SERCOM3:2 | TC7:0 | TCC0:6 | I2S/SCK[0] | GCLK_IO[4]
30 | PA21 | VDDIO | EXTINT[5] |  |  |  | X[9] |  | SERCOM5:3 | SERCOM3:3 | TC7:1 | TCC0:7 | I2S/FS[0] | GCLK_IO[5]
31 | PA22 | VDDIO | EXTINT[6] |  |  |  | X[10] |  | SERCOM3:0 | SERCOM5:0 | TC4:0 | TCC0:4 |  | GCLK_IO[6]
32 | PA23 | VDDIO | EXTINT[7] |  |  |  | X[11] |  | SERCOM3:1 | SERCOM5:1 | TC4:1 | TCC0:5 | USB/SOF 1kHz | GCLK_IO[7]
33 | PA24(6) | VDDIO | EXTINT[12] |  |  |  |  |  | SERCOM3:2 | SERCOM5:2 | TC5:0 | TCC1:2 | USB/DM
34 | PA25(6) | VDDIO | EXTINT[13] |  |  |  |  |  | SERCOM3:3 | SERCOM5:3 | TC5:1 | TCC1:3 | USB/DP
35 | GND
36 | VDDIO
37 | PB22 | VDDIO | EXTINT[6] |  |  |  |  |  |  | SERCOM5:2 | TC7:0 | TCC3:0 |  | GCLK_IO[0]
38 | PB23 | VDDIO | EXTINT[7] |  |  |  |  |  |  | SERCOM5:3 | TC7:1 | TCC3:1 |  | GCLK_IO[1]
39 | PA27 | VDDIO | EXTINT[15] |  |  |  |  |  |  |  | TCC3:6 |  |  | GCLK_IO[0]
40 | RESET~
41 | PA28 | VDDIO | EXTINT[8] |  |  |  |  |  |  |  | TCC3:7 |  |  | GCLK_IO[0]
42 | GND
43 | VDDCORE
44 | VDDIN
45 | PA30 | VDDIO | EXTINT[10] |  |  |  |  |  |  | SERCOM1:2 | TCC1:0 | TCC3:4 | SWCLK | GCLK_IO[0]
46 | PA31 | VDDIO | EXTINT[11] |  |  |  |  |  |  | SERCOM1:3 | TCC1:1 | TCC3:5 | SWDIO(5)
47 | PB02 | VDDANA | EXTINT[2] |  | AIN[10] |  | Y[8] |  |  | SERCOM5:0 | TC6:0 | TCC3:2
48 | PB03 | VDDANA | EXTINT[3] |  | AIN[11] |  | Y[9] |  |  | SERCOM5:1 | TC6:1 | TCC3:3

Sheet: CPU Options
ATSAMD21G18
Program Memory | 256K
Data Memory | 32K
Pins | 48
Internal
External | XOSC32K,XOSC
USB | Y
SERCOM | 6
TC / Waveform Outputs/TC | 2025-03-02
TCC | 3
Waveform Outputs/TCC | 8/4/2
I2S | Y
DMA | 12
RTC | Y
WDT | Y
Event SYstem | 12
External Interrupts | 16
I/O Pins | 38
ADC Channels | 14
Analog Comparator | 2
DAC | Y
PTC | 120/10

Sheet: TTL-3V3
 | Min | Max |  |  |  | VCC | Min | Max
Punch Data Inputs (IC5&6) |  |  | SN7409N
High Level Input Voltage | 2V | 5.5V
Low Level Input Voltage |  | 0.8 V
Low Level Input Current
Reader Data Outputs (IC3,4) |  |  | SN7417N
High Level output Voltage | 2.4V |  | 1K Pullup
Low Level output Voltage | 0.4V
ReaderData Output | IC5&6 | SN7417N | Hex bipolar buffers w/1K pullup |  | 74HTC165
VOH |  | 15 V | High-level output voltage | 1k Pullup to 4.5V | VIH | 2.0 V 3.3 V 4.5V | 1.5 V 2.36 V 3.15 V |  | High-level input voltage
IOL |  | 40 mA | Low-level input current
VOL |  | 0.7 V | Low-level output voltage |  | VIL | 2.0 V 3.3 V 4.5V |  | 0.5 V 0.94 V 1.35 V | Low-level input voltage
PunchData Input | IC3&4 | IC7409N | Quad 2-In Open Collector AND |  | 74HTC595
VIH | 2 V |  | High-level input voltage |  | VOH | 2.0 V 3.3 V 4.5V | 1.9 V 3.2 V 4.4 V |  | High-level output voltage
VIL |  | 0.8 V | Low-level input voltage |  | VOL | 2.0 V 3.3 V 4.5V |  | 0.1 V 0.1 V 0.1 V | Low-level oputput voltage
IIH |  | 40 uA | High-level input current
IIL |  | -1.6 mA | Low-level input current
Reader Start~ Input | IC14 | 9600 | Monostable Multivibrator |  | 74HCT04
VIH | 1.5 V |  | High-level input voltage |  | VOH | 2.0 V 3.3 V 4.5V | 1.9 V 3.2 V 4.4 V |  | High-level output voltage
VIL |  | 0.85 V | Low-level input voltage |  | VOL | 2.0 V 3.3 V 4.5V |  | 0.1 V 0.1 V 0.1 V | Low-level oputput voltage
IIH |  |  | High-level input current
IIL |  | -1.6 mA | Low-level input current
PunchStart Input | IC10 | SN7408N | Quad 2-In AND |  | 75HCT04
VIH | 2 V |  | High-level input voltage |  | VOH | 2.0 V 3.3 V 4.5V | 1.9 V 3.2 V 4.4 V |  | High-level output voltage
VIL |  | 0.8 V | Low-level input voltage |  | VOL | 2.0 V 3.3 V 4.5V |  | 0.1 V 0.1 V 0.1 V | Low-level oputput voltage
IIH |  | 40 uA | High-level input current
IIL |  | -1.6 mA | Low-level input current
Reader Ready Output | IC7 | SN7417N
PunchReady Output | IC7 | SN7417N
PunchReady~ Output | IC7 | SN7417N |  |  | 75HCT04
VOH |  | 15 V | High-level output voltage | 1k Pullup to 4.4V | VIH | 2.0 V 3.3 V 4.5V | 1.5 V 2.36 V 3.15 V |  | High-level input voltage
VOL |  | 0.7 V | Low-level output voltage |  | VIL | 2.0 V 3.3 V 4.5V |  | 0.5 V 0.94 V 1.35 V | Low-level input voltage

Sheet: Char Map
 |  |  |  |  |  |  |  |  | 49 | $K$21 | $L$21 | $M$21 | $N$21 | $O$21 | $P$21
 |  |  |  |  |  |  |  |  | Si | 00000000 | 00000000 | 01000010 | 01111111 | 01000000 | 00000000
 |  |  |  |  |  |  |  |  |  | Col 0 | Col 1 | Col 2 | Col 3 | Col 4 | Col 5 |  |  |  |  | byte [][] CharMap = {
32 | 0x20 |  | 0x00 | 0x00 | 0x00 | 0x00 | 0x00 | 0x00 |  | 0 | 0 | 0 | 0 | 0 | 0 | 8 |  | . |  | {,0x00,0x00,0x00,0x00,0x00}, // 0x20
33 | 0x21 | ! | 0x00 | 0x00 | 0x00 | 0x6f | 0x00 | 0x00 | ! | 0 | 0 | 0 | 1101111 | 0 | 0 | 7 | . | . |  | {0x00,0x00,0x00,0x6f,0x00,0x00}, // 0x21 !
34 | 0x22 | " | 0x00 | 0x00 | 0x07 | 0x00 | 0x07 | 0x00 | " | 0 | 0 | 111 | 0 | 111 | 0 | 6 |  | . |  | {0x00,0x00,0x07,0x00,0x07,0x00}, // 0x22 "
35 | 0x23 | # | 0x00 | 0x14 | 0x7f | 0x14 | 0x7f | 0x14 | # | 0 | 10100 | 1111111 | 10100 | 1111111 | 10100 | 5 |  | . |  | {0x00,0x14,0x7f,0x14,0x7f,0x14}, // 0x23 #
36 | 0x24 | $ | 0x00 | 0x00 | 0x07 | 0x04 | 0x1e | 0x00 | $ | 0 | 0 | 111 | 100 | 11110 | 0 | 4 |  | . |  | {0x00,0x00,0x07,0x04,0x1e,0x00}, // 0x24 $
37 | 0x25 | % | 0x00 | 0x23 | 0x13 | 0x08 | 0x64 | 0x62 | % | 0 | 100011 | 10011 | 1000 | 1100100 | 1100010 | 3 |  | . |  | {0x00,0x23,0x13,0x08,0x64,0x62}, // 0x25 %
38 | 0x26 | & | 0x00 | 0x36 | 0x49 | 0x56 | 0x20 | 0x50 | & | 0 | 110110 | 1001001 | 1010110 | 100000 | 1010000 | 2 | . | . | . | {0x00,0x36,0x49,0x56,0x20,0x50}, // 0x26 &
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
127 | 0x7F |  | 0x00 | 0x7f | 0x6b | 0x6b | 0x6b | 0x7f |  | 0 | 1111111 | 1101011 | 1101011 | 1101011 | 1111111 |  |  |  |  | {0x00,0x7f,0x6b,0x6b,0x6b,0x7f}, // 0x7F
 |  |  |  |  |  |  |  |  |  |  |  |  |  |  |  |  |  |  |  | };

Sheet: Simulator Wiring
H10 Reader/Punch |  |  |  |  | H10 Simulator
 | 3V3 |  | 1 | <-> | 3V3
Serial data from Reader data 165 | pMISO | Input | 2 | n.c | Output | sMOSI | Serial data to simulated reader 595
Clock to 165 & 595 | pSCK | Output | 3 | n.c | Output | sSCK | Clock to 595 & 165
Latch signal to Punch data 595 | pPunchDataLatch | Output | 4 | n.c | Output | sPunchDataLoad | Load signal to simulated punch data 165
Serial data to Punch data 595 | pMOSI | Output | 5 | n.c | Input | sMISO | Serial data from simulated punch data 165
Load signal to Reader data 165 | pReadDataLoad | Output | 6 | n.c | Output | sReadDataLatch | Latch signal to simulated punch 595
 | GND |  | 7 | <-> | GND
Start Read cycle | pReaderStart | Output | 8 | -> | Input | sReaderStart | Input to monitor ReadStart
Reader is ready to cycle | pReaderReady | Input | 9 | <- | Output | sReaderReady | Output to simulate ReadReady
Punch is ready to cycle | pPunchReady | Input | 10 | <- | Output | sPunchReady | Output to simulate PunchReady
Start a Punch cycle | pPunchStart | Output | 11 | -> | Input | sPunchStart | Input to monitor PunchStart
 | GND |  | 12 | <-> | GND
 | pRD0 | Input |  | <- | Output | sRD0
 | pRD1 | Input |  | <- | Output | sRD1
 | pRD2 | Input |  | <- | Output | sRD2
 | pRD3 | Input |  | <- | Output | sRD3
 | pRD4 | Input |  | <- | Output | sRD4
 | pRD5 | Input |  | <- | Output | sRD5
 | pRD6 | Input |  | <- | Output | sRD6
 | pRD7 | Input |  | <- | Output | sRD7
 | pPD0 | Output |  | -> | Input | sPD0
 | pPD1 | Output |  | -> | Input | sPD1
 | pPD2 | Output |  | -> | Input | sPD2
 | pPD3 | Output |  | -> | Input | sPD3
 | pPD4 | Output |  | -> | Input | sPD4
 | pPD5 | Output |  | -> | Input | sPD5
 | pPD6 | Output |  | -> | Input | sPD6
 | pPD7 | Output |  | -> | Input | sPD7

Sheet: Pi Pico Pinout
 |  | H10 Controller |  | H10 Simulator
1 | GP0 | PunchStart
2 | GP1 | PunchReady
3 | GND
4 | GP2 | RTS1 | FTDI USB Header
5 | GP3 | CTS1 | FTDI USB Header
6 | GP4 | Tx1 | FTDI USB Header
7 | GP5 | Rx1 | FTDI USB Header
8 | GND
9 | GP6 | ReaderReady
10 | GP7 | ReadyStart
11 | GP8 | REadDataLoad
12 | GP9 | PunchDataLatch
13 | GND
14 | GP10 | SCK
15 | GP11 | MOSI
16 | GP12 | MISO
17 | GP13
18 | GND | PB1
19 | GP14 | LED2
20 | GP15 | LED1
21 | GP16 | Tx0 | MAX3232 RS232 Interface
22 | GP17 | Rx0 | MAX3232 RS232 Interface
23 | GND
24 | GP18 | CTS0 | MAX3232 RS232 Interface
25 | GP19 | RTS0 | MAX3232 RS232 Interface
26 | GP20
27 | GP21
28 | GND |  | Ground
29 | GP22
30 | RUN
31 | GP26
32 | GP27
33 | GND |  | Ground
34 | GP28
35 | ADC_VREF
36 | 3V3 OUT | 3V3 | 3V3 power
37 | 3V3_EN
38 | GND | GND | Ground
39 | VSYS | VSYS | 5V from buck regulator
40 | VBUS | VBUS | 5V from USB

Sheet: RS232
 |  |  | Front Pinout
Computer COM port is male DTE |  |  | 1 2 3 4 5 6 7 8 9
H10 COM port will be a female DCE |  |  | 5 4 3 2 1 9 8 7 6
 | DTE |  | DCE
1 | DCD | << | DCD | DCD notifies DTE that the carrier has been detected
2 | RXD | << | RXD | DCE send data to DTE
3 | TXD | >> | TXD | DTE send data to DCE
4 | DTR | >> | DTR | DTR indicates that is is ready
5 | GND | <> | GND | Gound
6 | DSR | << | DSR | DCE notifies DTE that it is ready
7 | RTS | >> | RTS | DTE is requesting to send data
8 | CTS | << | CTS | DCE indicates that is DTE can send data
9 | RI | << | RI | DCE notifies DTE that the phone is ringing
 | DTE to DTE Null Modem Cable
1 | NC | NC | 1
2 | RX | TX | 3
3 | TX | RX | 2
4 | DTR | DSR | 6
5 | GND | GND | 5
6 | DSR | DTR | 4
7 | RTS | CTS | 8
8 | CTS | RTS | 7
9 | NC | NC | 9
 | DTE to DTE Null Modem Cable
2 | RX | TX | 3
3 | TX | RX | 2
4 | DTR | DSR,DCD | 1,6
5 | GND | GND | 5
6,1 | DSR,DCD | DTR | 4
7 | RTS | CTS | 8
8 | CTS | RTS | 7
 |  |  |  | Arduino | Dir | Max232 |  | DB9 DTE | RS232 Pin |  | DB9 DTE
 |  |  | D0 | Tx | >> | T1IN | T1OUT | Tx | 3 | H10 Transmit Data Out | 2 RX | PC Receive Data
 |  |  | D1 | Rx | << | R1OUT | R1IN | Rx | 2 | H10 Receive Data In | 3 TX | PC Send Data
 |  |  | D2 | RTS | >> | T2IN | T2OUT | RTS | 7 | H10 Request To Send Out | 8 CTS | PC Ok to Send Data
 |  |  | D3 | CTS | << | R2Out | R2IN | CTS | 8 | H10 Clear To Send In | 7 RTS | PC Ready to Recv Data
