tlsystems/H10-Paper-Tape-Reader-Punch/Heathkit H10 Info/H10 Manuals/H10 PCB X-Ray.pdf

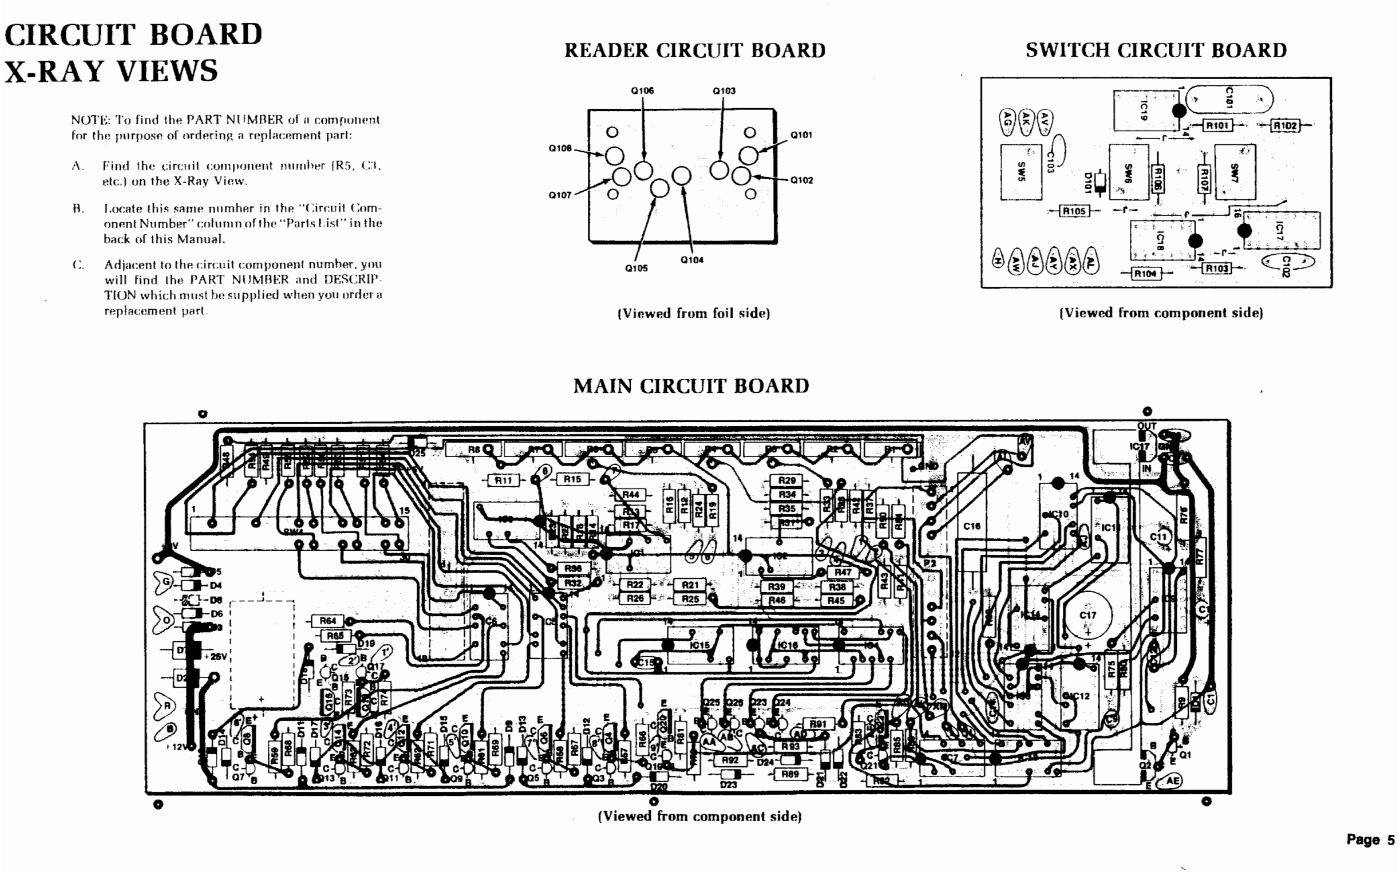
[picture p3: page 1]
