tlsystems/H10-Paper-Tape-Reader-Punch/Heathkit H10 Info/H10 Manuals/h10-sch.pdf

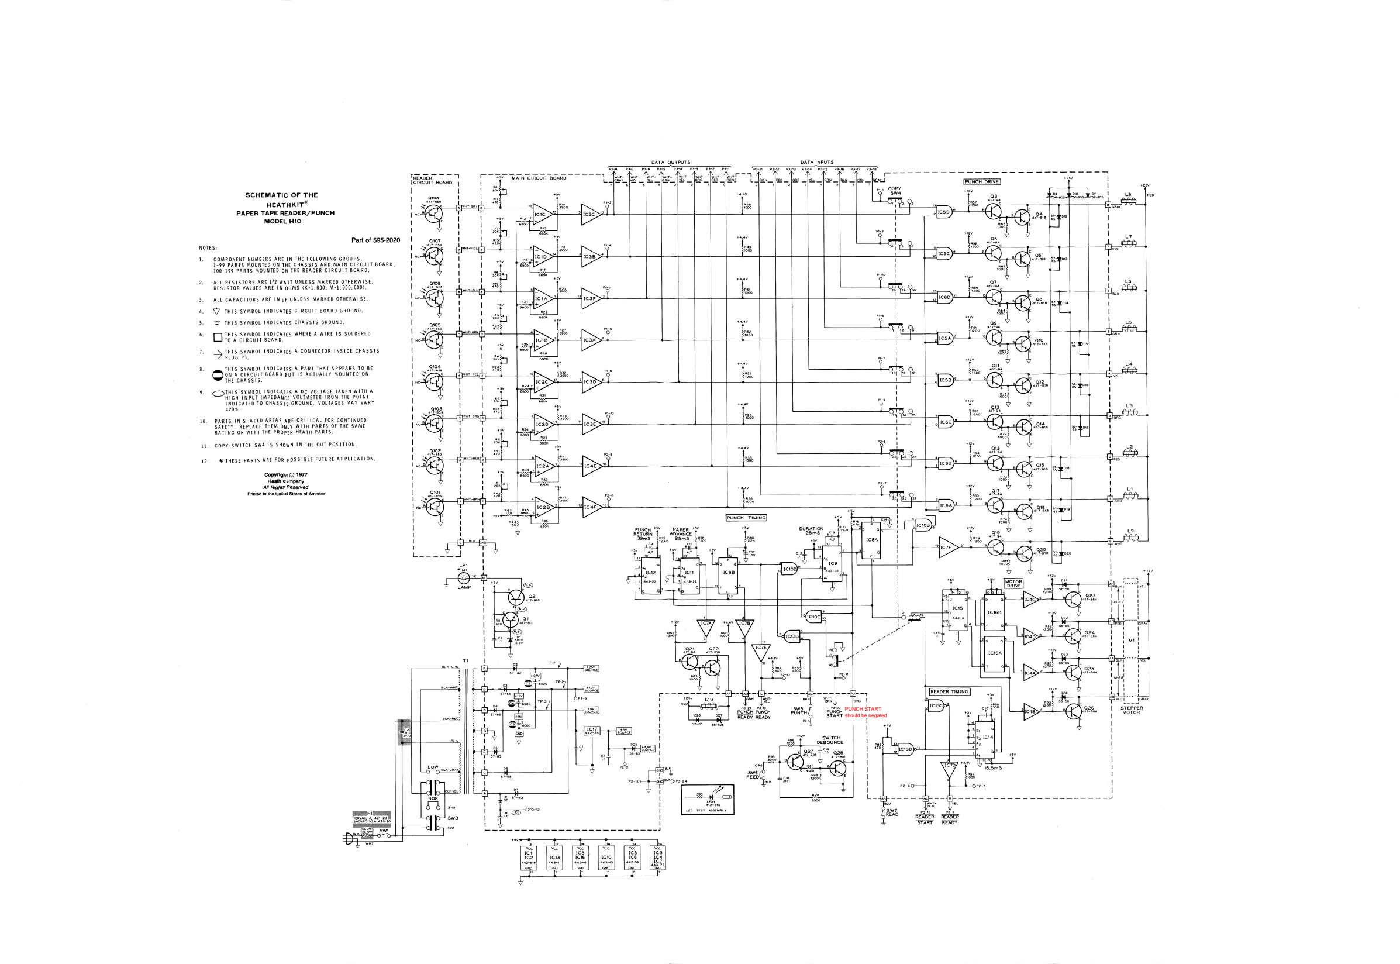
[picture p4: page 1]
