tlsystems/H10-Paper-Tape-Reader-Punch/Kicad/H10 Pi Pico/Mechanical Parts/DB9 Male.pdf

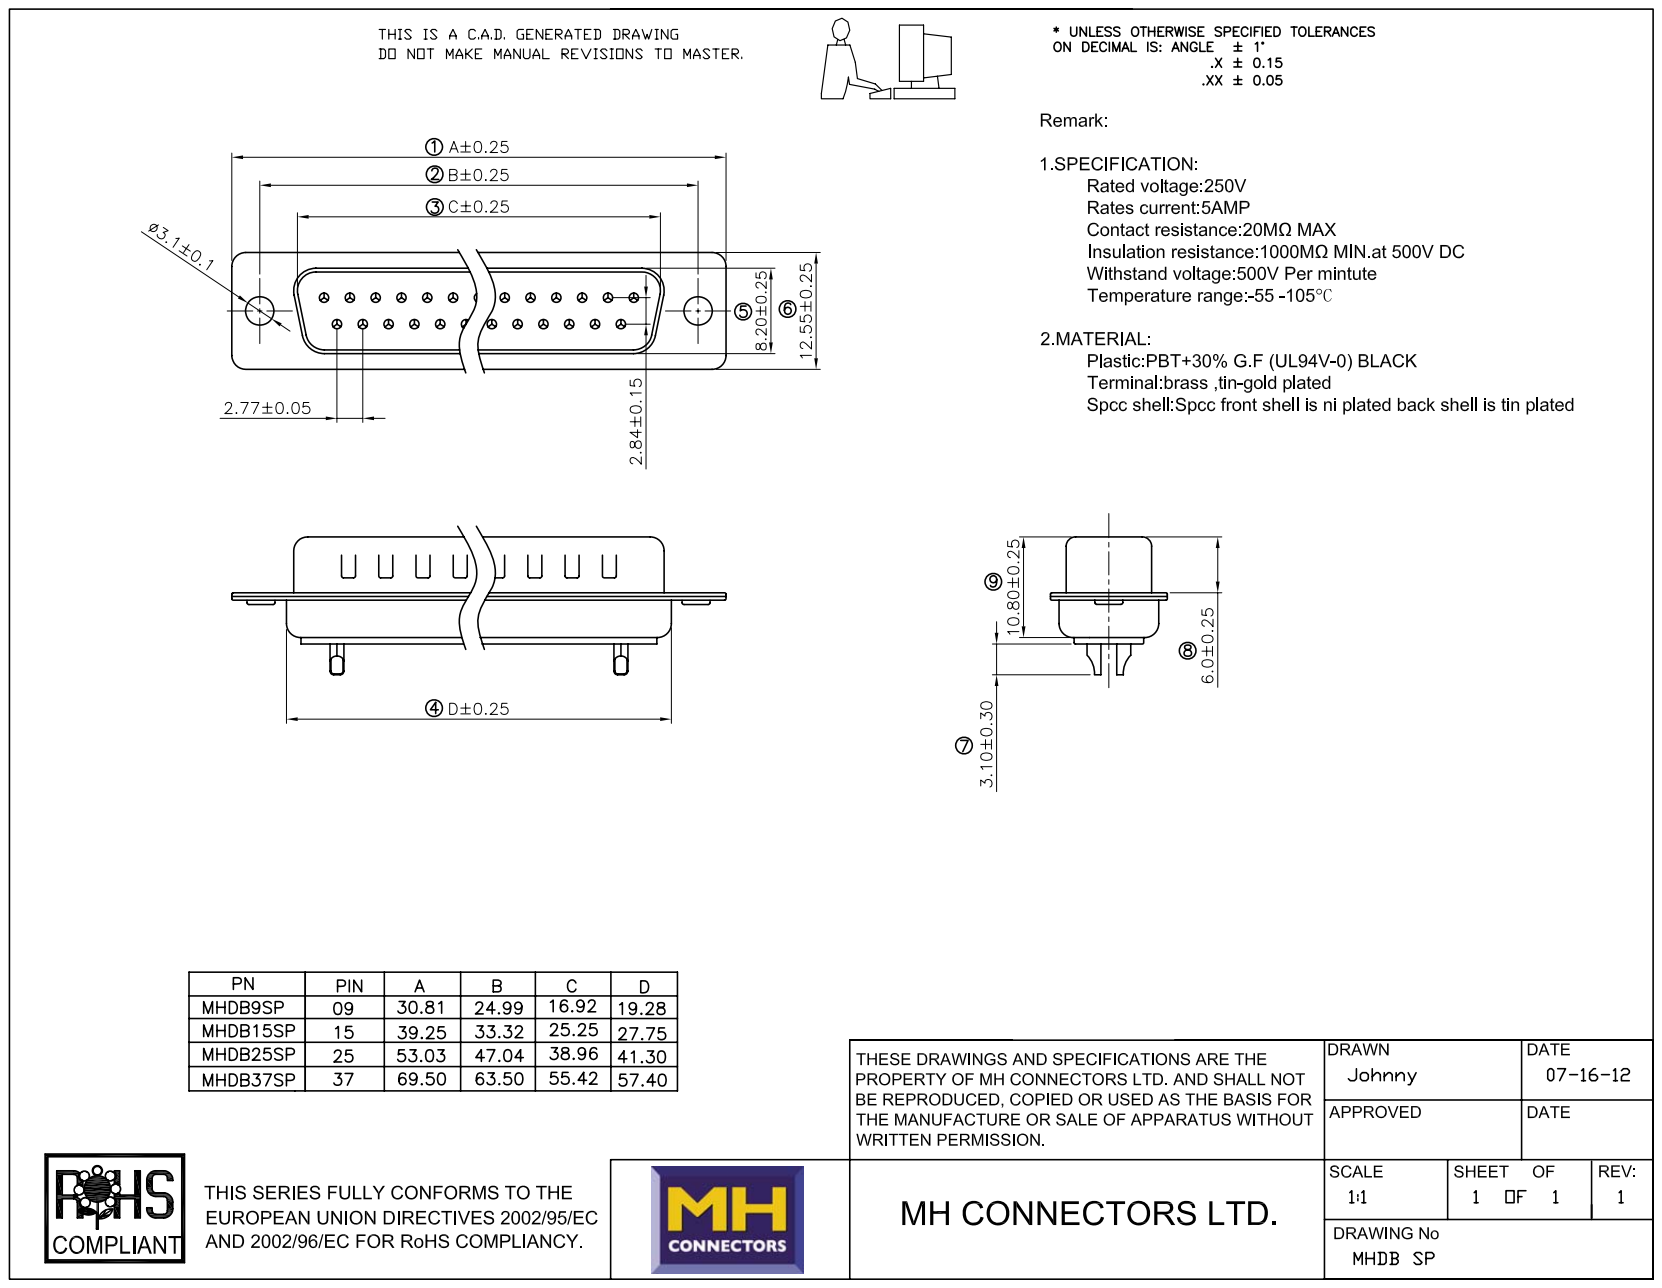
[picture p5: page 1]
