tlsystems/H10-Paper-Tape-Reader-Punch/Heathkit H10 Info/H10 Manuals/H10 KiCad Schematic.pdf

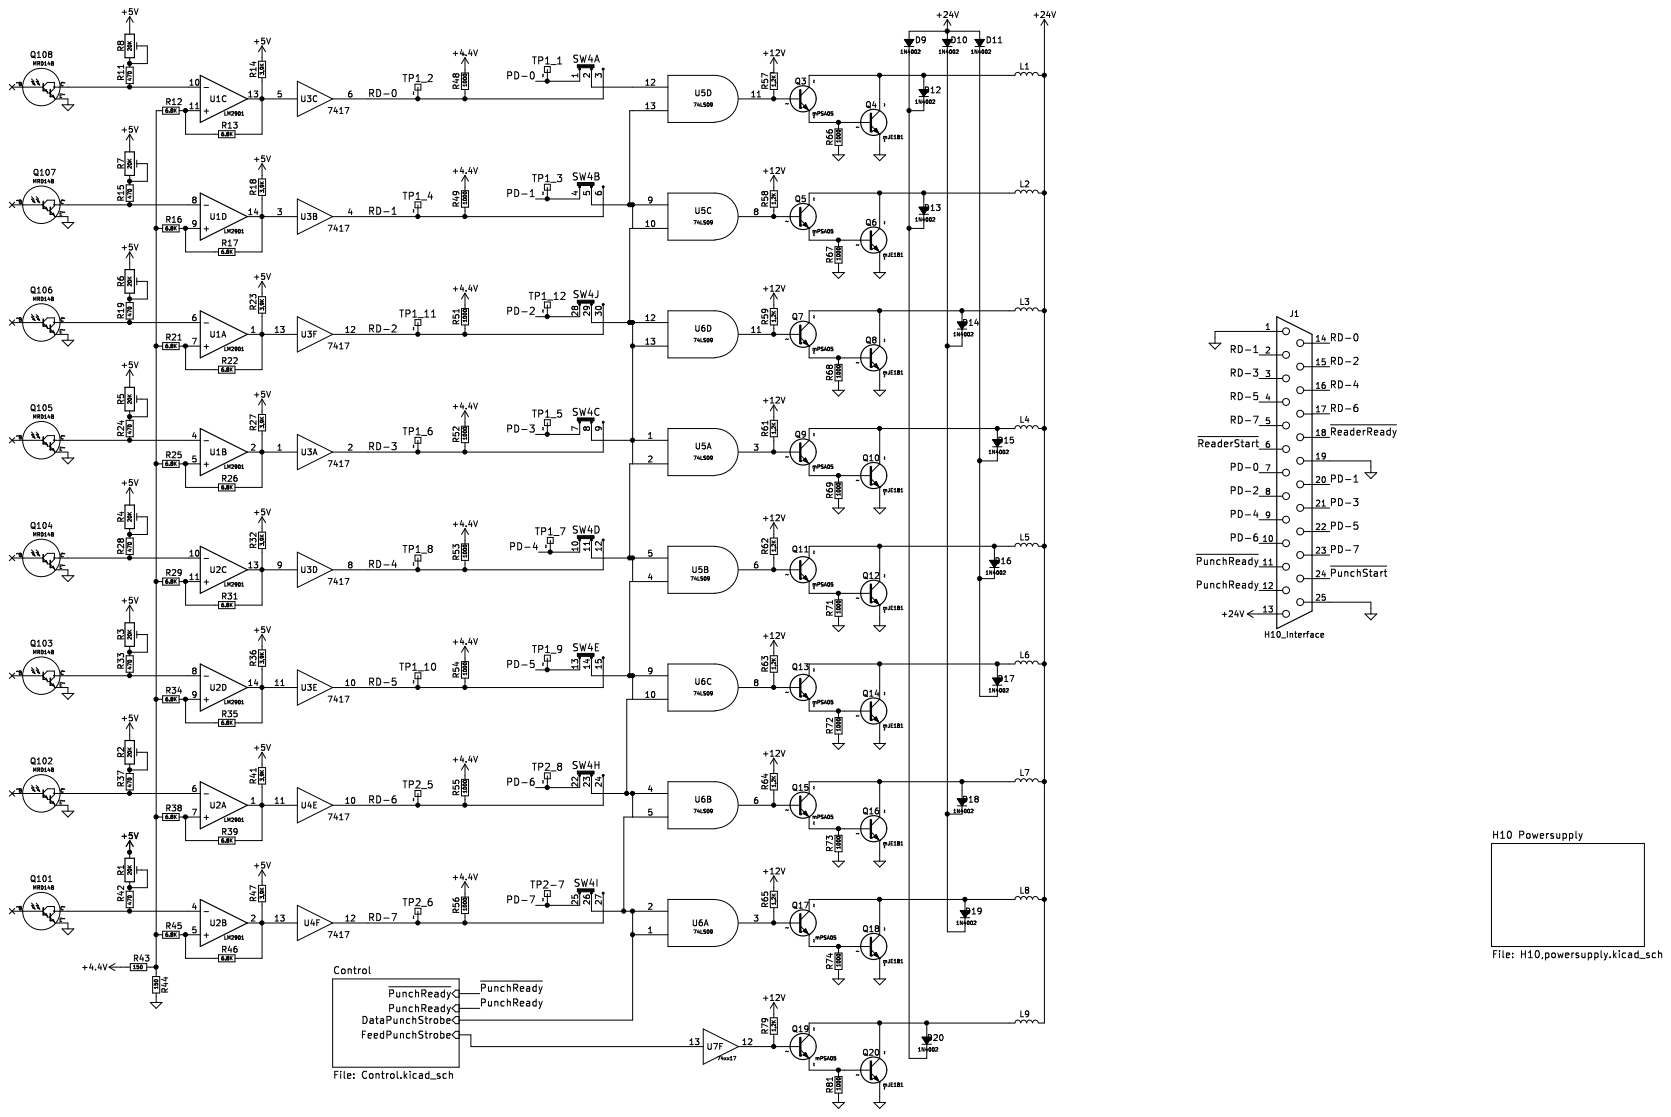
[picture p6: page 1]

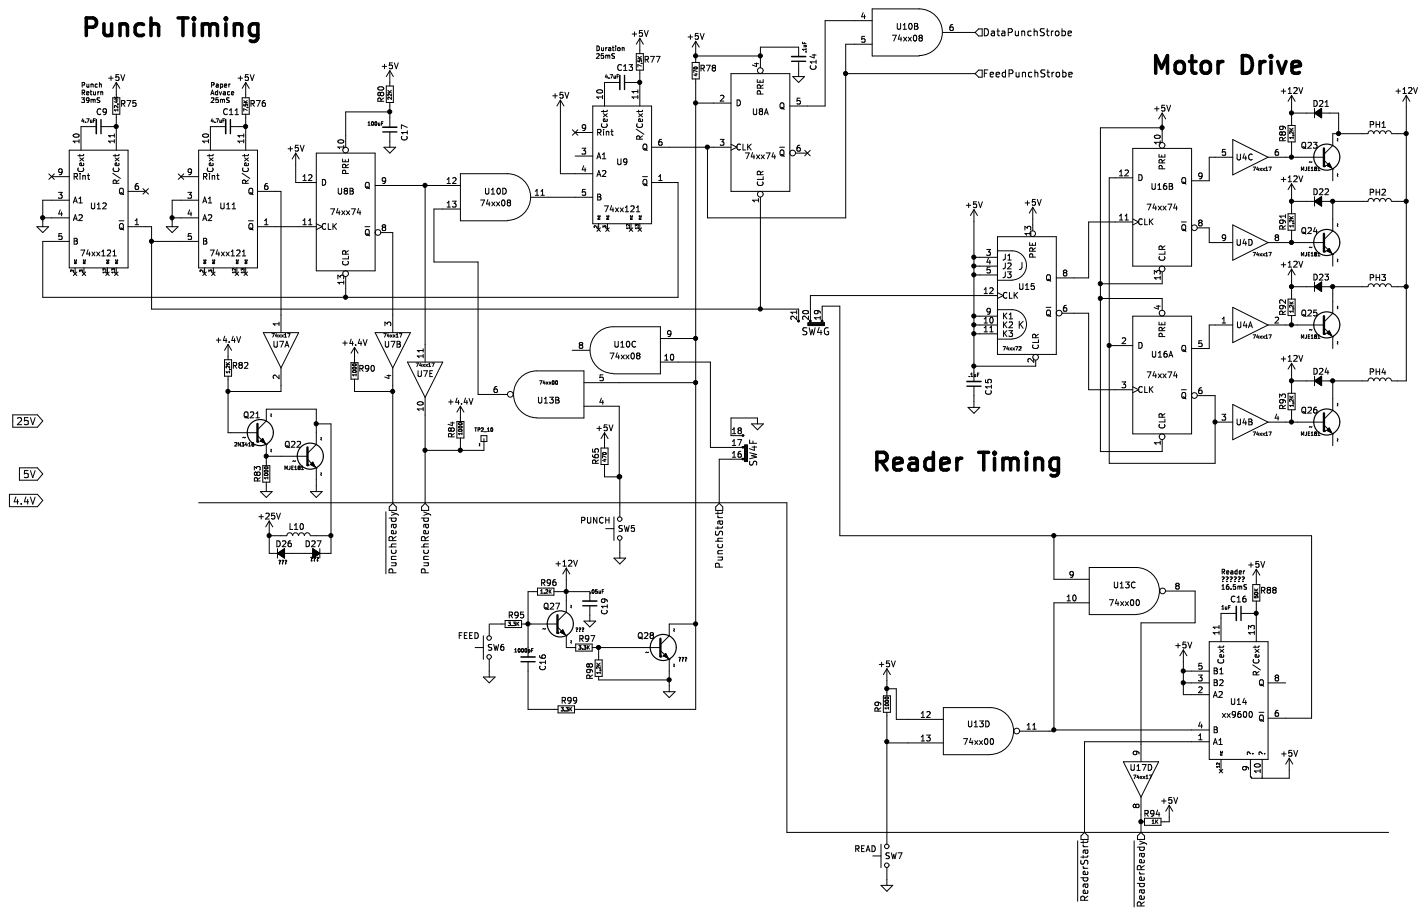
[picture p7: page 2]

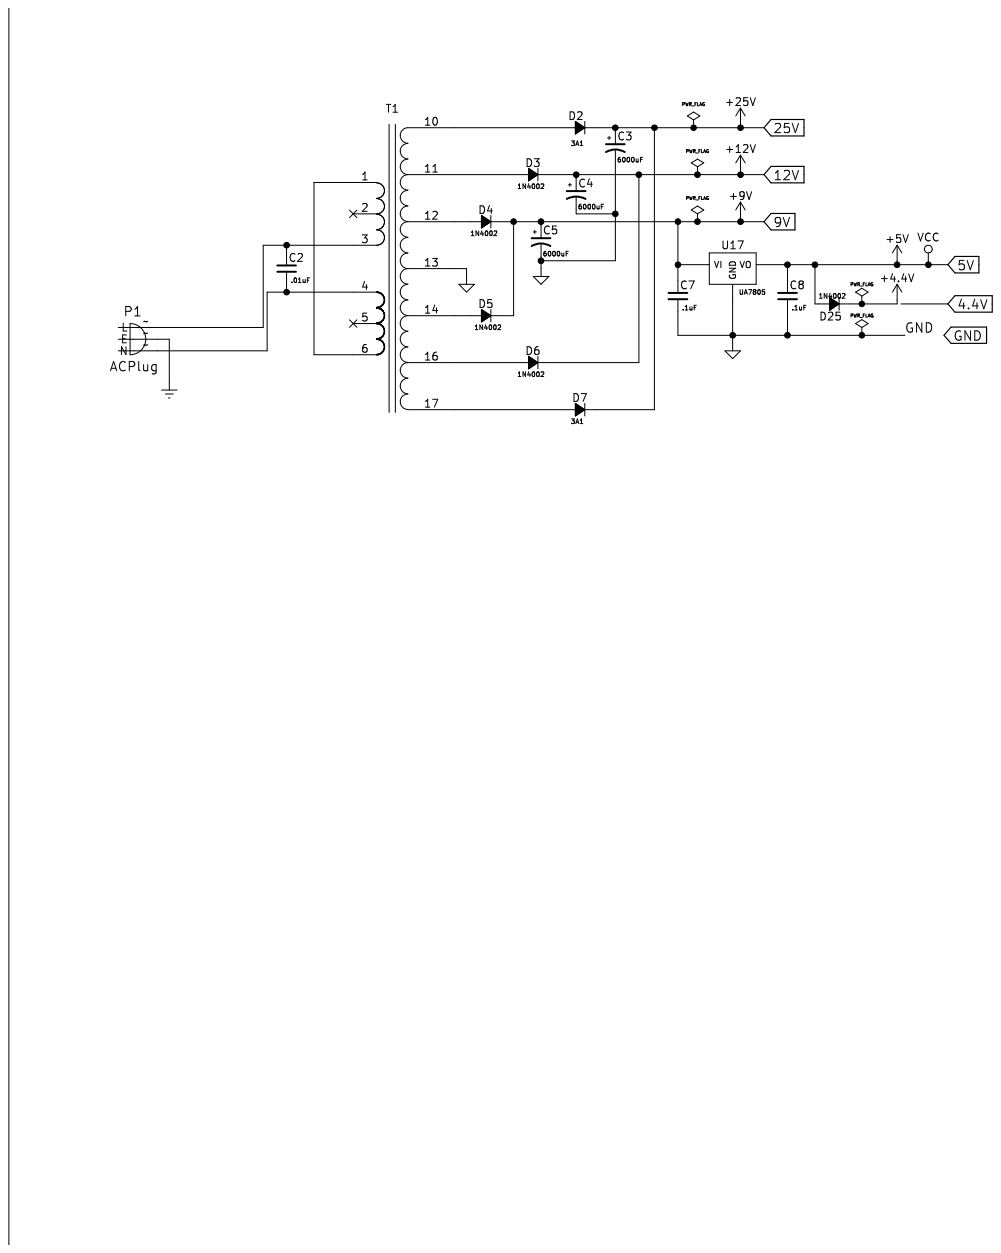
[picture p8: page 3]
