tlsystems/H10-Paper-Tape-Reader-Punch/Kicad/H10-Breakout/H10-Breakout.kicad_pcb

## KiCad design Kicad/H10-Breakout/H10-Breakout.kicad_pcb (2026-03-24)

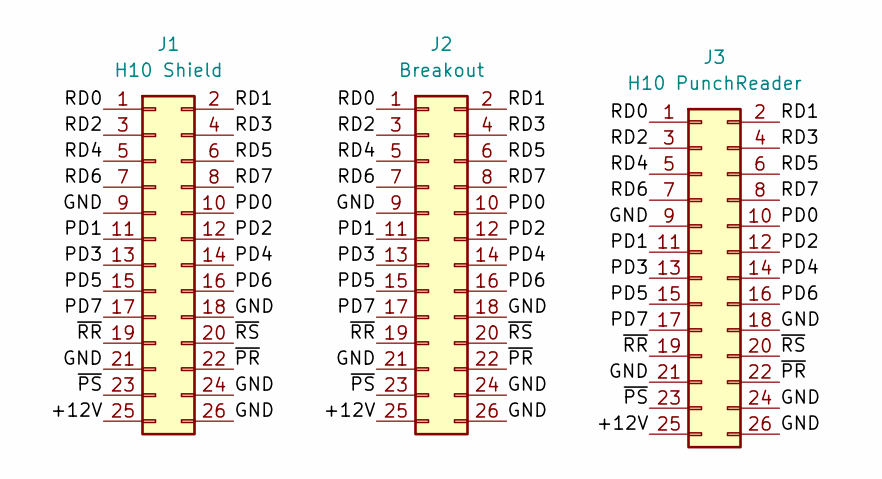
[picture p9: schematic H10-Breakout.kicad_sch]

Parts:
J1: H10 Shield; PinSocket_2x13_P2.54mm_Vertical
J2: Breakout; PinHeader_2x13_P2.54mm_Vertical
J3: H10 PunchReader; PinHeader_2x13_P2.54mm_Vertical

Connections:
/+12V: J1.25, J2.25, J3.25
/GND: J1.9, J1.18, J1.21, J1.24, J1.26, J2.9, J2.18, J2.21, J2.24, J2.26, J3.9, J3.18, J3.21, J3.24, J3.26
/PD0: J1.10, J2.10, J3.10
/PD1: J1.11, J2.11, J3.11
/PD2: J1.12, J2.12, J3.12
/PD3: J1.13, J2.13, J3.13
/PD4: J1.14, J2.14, J3.14
/PD5: J1.15, J2.15, J3.15
/PD6: J1.16, J2.16, J3.16
/PD7: J1.17, J2.17, J3.17
/RD0: J1.1, J2.1, J3.1
/RD1: J1.2, J2.2, J3.2
/RD2: J1.3, J2.3, J3.3
/RD3: J1.4, J2.4, J3.4
/RD4: J1.5, J2.5, J3.5
/RD5: J1.6, J2.6, J3.6
/RD6: J1.7, J2.7, J3.7
/RD7: J1.8, J2.8, J3.8
/~PR: J1.22, J2.22, J3.22
/~PS: J1.23, J2.23, J3.23
/~RR: J1.19, J2.19, J3.19
/~RS: J1.20, J2.20, J3.20

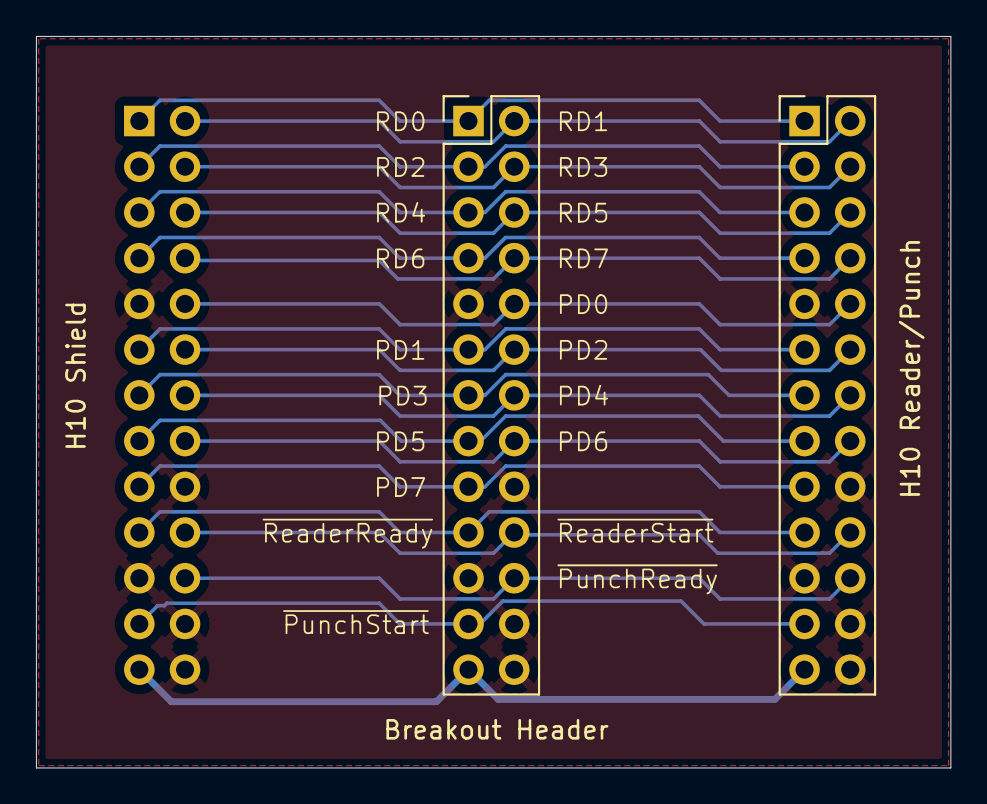
[picture p10: board H10-Breakout.kicad_pcb from above]

Board: 2 copper layers, 50.8 x 40.6 mm, 3 parts (1 on the bottom side), 22 nets.
