tlsystems/H10-Paper-Tape-Reader-Punch/Kicad/H10 Simulator/H10 Simulator.kicad_pcb

## KiCad design Kicad/H10 Simulator/H10 Simulator.kicad_pcb (2026-03-20)

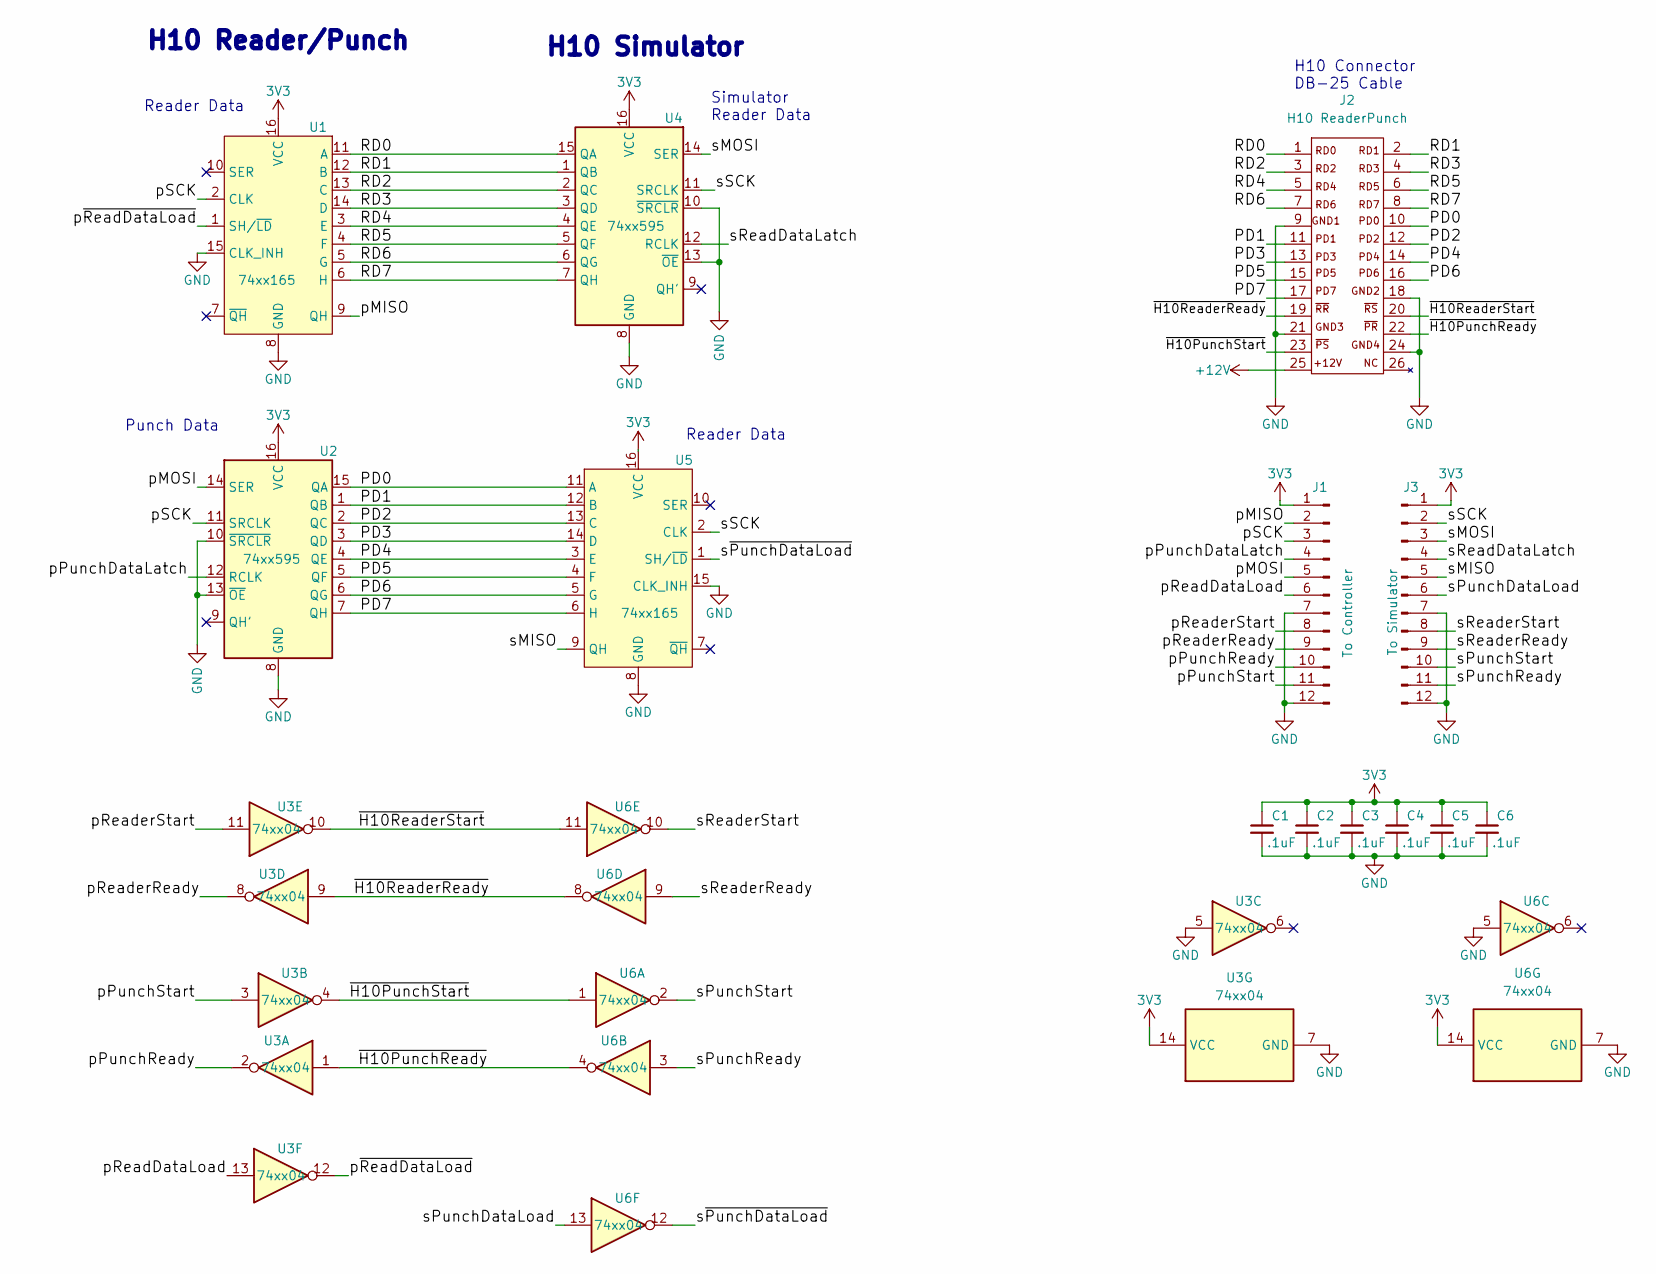
[picture p11: schematic H10 Simulator.kicad_sch, H10 Simulator Interconnection Logic]

Parts:
C1, C2, C3, C4, C5, C6: .1uF; C_0603_HandSoldering
J1: To Controller; PinHeader_1x12_P2.54mm_Vertical
J2: H10 ReaderPunch; PinHeader_2x13_P2.54mm_Vertical
J3: To Simulator; PinHeader_1x12_P2.54mm_Vertical
U1, U5: 74xx165; SOIC-16_3.9x9.9mm_P1.27mm
U2, U4: 74xx595; SOIC-16_3.9x9.9mm_P1.27mm
U3, U6: 74xx04; SOIC-14_3.9x8.7mm_P1.27mm

Connections:
3V3: C1.1, C2.1, C3.1, C4.1, C5.1, C6.1, J1.1, J3.1, U1.16 (VCC), U2.16 (VCC), U3.14 (VCC), U4.16 (VCC), U5.16 (VCC), U6.14 (VCC)
+12V: J2.25
/PD0: J2.10, U2.15 (QA), U5.11 (A)
/PD1: J2.11, U2.1 (QB), U5.12 (B)
/PD2: J2.12, U2.2 (QC), U5.13 (C)
/PD3: J2.13, U2.3 (QD), U5.14 (D)
/PD4: J2.14, U2.4 (QE), U5.3 (E)
/PD5: J2.15, U2.5 (QF), U5.4 (F)
/PD6: J2.16, U2.6 (QG), U5.5 (G)
/PD7: J2.17, U2.7 (QH), U5.6 (H)
/RD0: J2.1, U1.11 (A), U4.15 (QA)
/RD1: J2.2 (RD1), U1.12 (B), U4.1 (QB)
/RD2: J2.3, U1.13 (C), U4.2 (QC)
/RD3: J2.4, U1.14 (D), U4.3 (QD)
/RD4: J2.5, U1.3 (E), U4.4 (QE)
/RD5: J2.6, U1.4 (F), U4.5 (QF)
/RD6: J2.7, U1.5 (G), U4.6 (QG)
/RD7: J2.8, U1.6 (H), U4.7 (QH)
/pMISO: J1.2, U1.9 (QH)
/pMOSI: J1.5, U2.14 (SER)
/pPunchDataLatch: J1.4, U2.12 (RCLK)
/pPunchReady: J1.10, U3.2
/pPunchStart: J1.11, U3.3
/pReadDataLoad: J1.6, U3.13
/pReaderReady: J1.9, U3.8
/pReaderStart: J1.8, U3.11
/pSCK: J1.3, U1.2 (CLK), U2.11 (SRCLK)
/p~ReadDataLoad: U1.1 (SH/~LD), U3.12
/sMISO: J3.5, U5.9 (QH)
/sMOSI: J3.3, U4.14 (SER)
/sPunchDataLoad: J3.6, U6.13
/sPunchReady: J3.11, U6.3
/sPunchStart: J3.10, U6.2
/sReadDataLatch: J3.4, U4.12 (RCLK)
/sReaderReady: J3.9, U6.9
/sReaderStart: J3.8, U6.10
/sSCK: J3.2, U4.11 (SRCLK), U5.2 (CLK)
/s~PunchDataLoad: U5.1 (SH/~LD), U6.12
/~H10PunchReady: J2.22, U3.1, U6.4
/~H10PunchStart: J2.23, U3.4, U6.1
/~H10ReaderReady: J2.19, U3.9, U6.8
/~H10ReaderStart: J2.20, U3.10, U6.11
GND: C1.2, C2.2, C3.2, C4.2, C5.2, C6.2, J1.7, J1.12, J2.9, J2.18 (GND2), J2.21, J2.24, J3.7, J3.12, U1.8 (GND), U1.15 (CLK_INH), U2.8 (GND), U2.10 (~SRCLR), U2.13 (~OE), U3.5, U3.7 (GND), U4.8 (GND), U4.10 (~SRCLR), U4.13 (~OE), U5.8 (GND), U5.15 (CLK_INH), U6.5, U6.7 (GND)

Notes on the sheet:
Reader Data
Punch Data
H10 Simulator
Simulator Reader Data
H10 Reader/Punch
H10 Connector DB-25 Cable

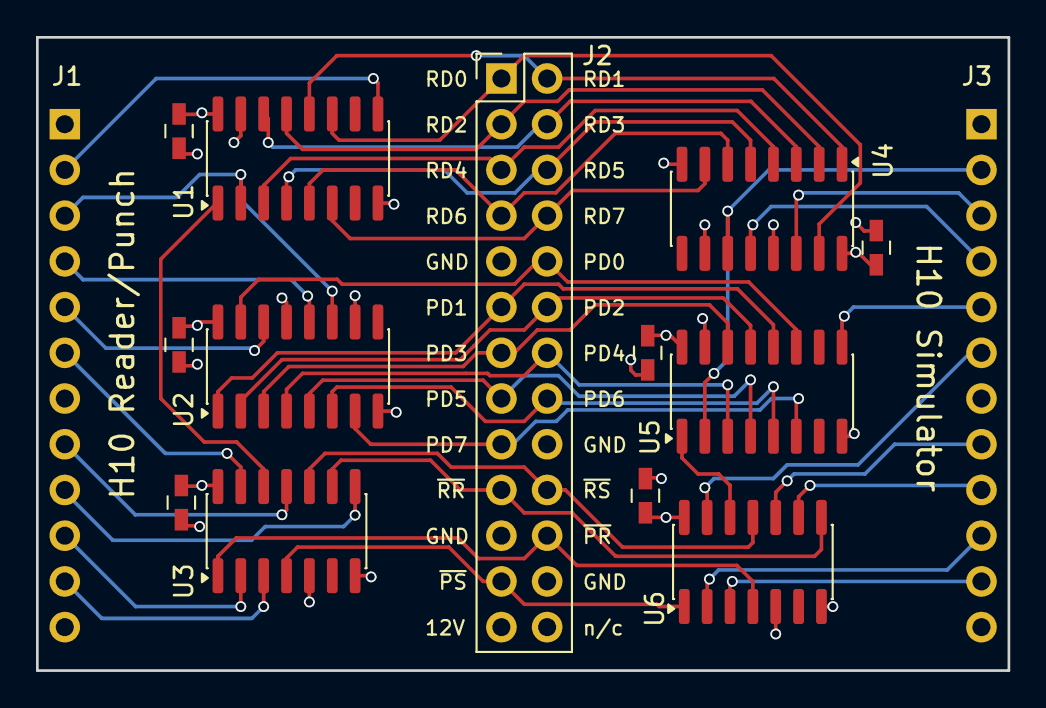
[picture p12: board H10 Simulator.kicad_pcb from above]

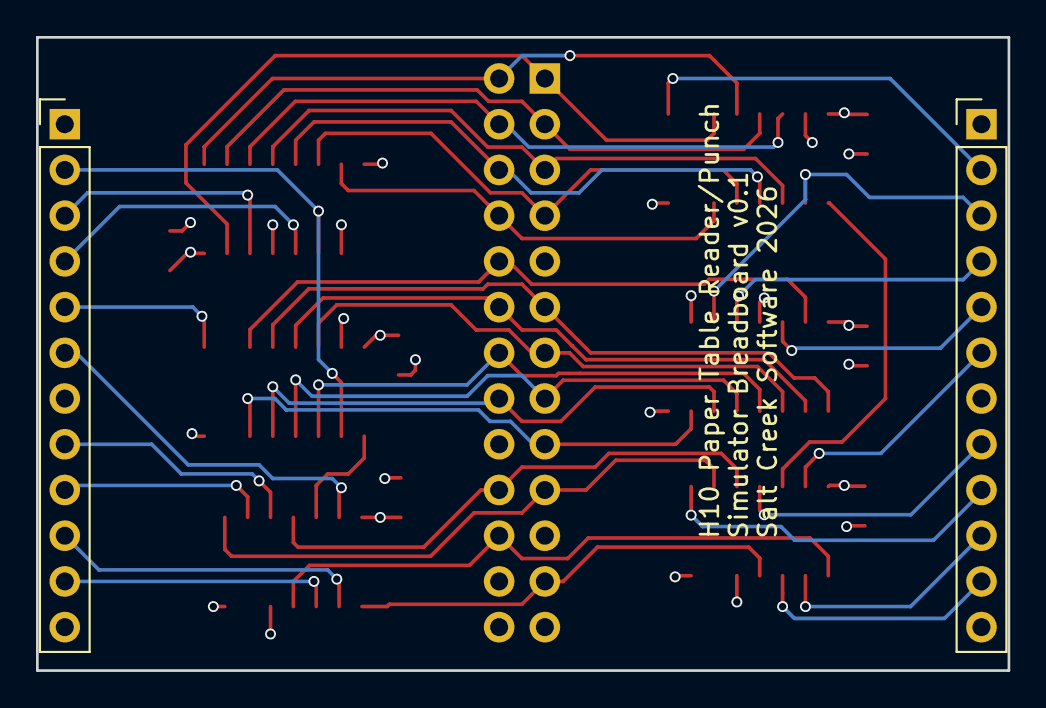
[picture p13: board H10 Simulator.kicad_pcb from below]

Board: 4 copper layers, 54.0 x 35.2 mm, 15 parts (2 on the bottom side), 42 nets.
