tlsystems/H10-Paper-Tape-Reader-Punch/Kicad/H10 Pi Pico/H10 Pi Pico.kicad_pcb

## KiCad design Kicad/H10 Pi Pico/H10 Pi Pico.kicad_pcb (2026-03-19)

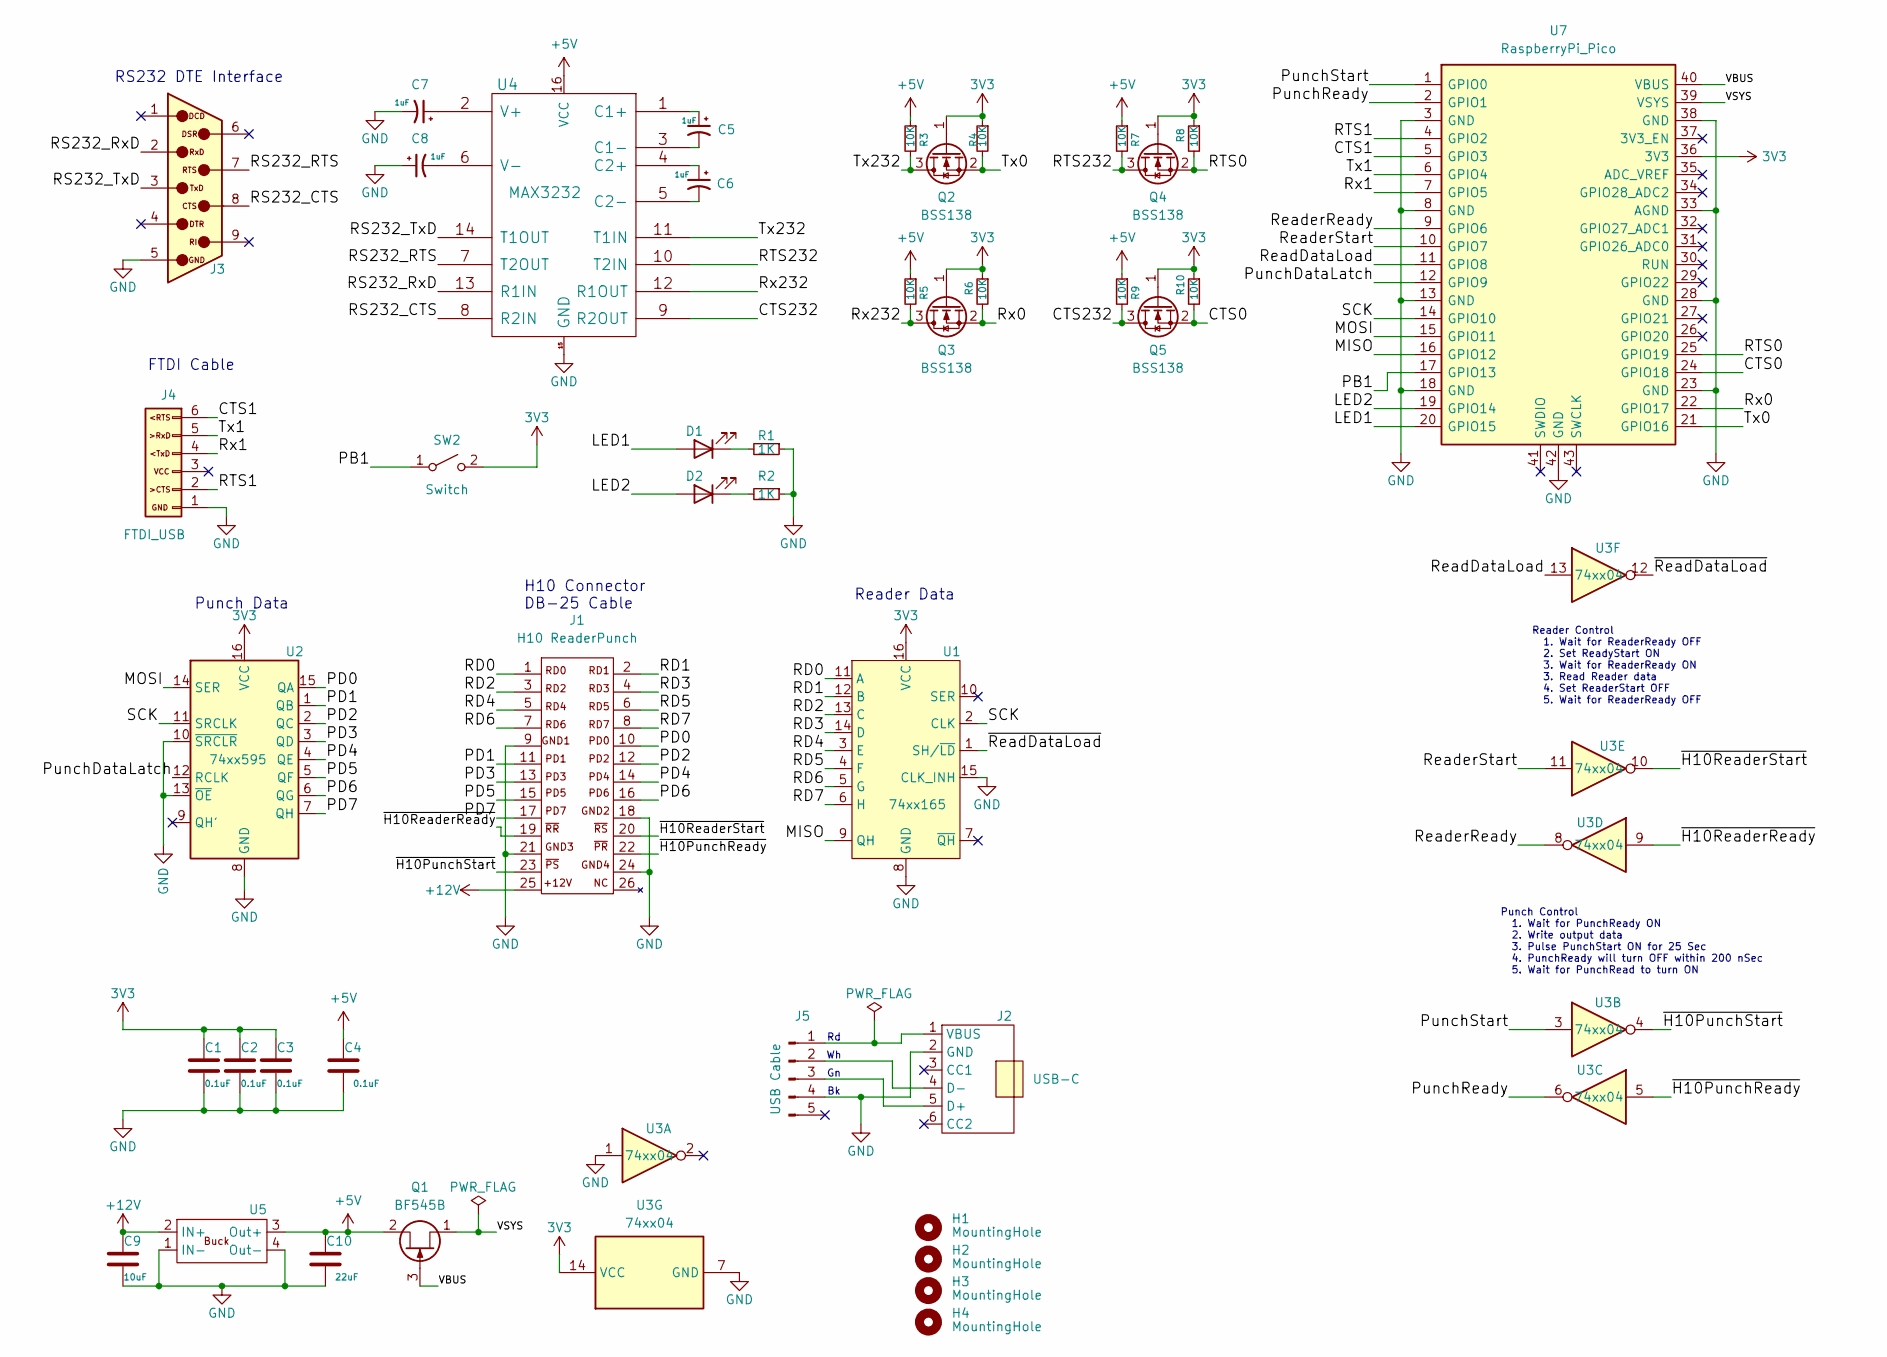
[picture p14: schematic H10 Pi Pico.kicad_sch, Serial Interface for H10 Punch/Reader]

Parts:
C1, C2, C3, C4: 0.1uF; C_0603_1608Metric
C5, C6, C7, C8: 1uF; C_0603_1608Metric
C9: 10uF; C_0805_2012Metric
C10: 22uF; C_0805_2012Metric
D1, D2: LED; LED_0805_2012Metric_Pad1.15x1.40mm_HandSolder
H1, H2, H3, H4: MountingHole; MountingHole_3.2mm_M3
J1: H10 ReaderPunch; PinHeader_2x13_P2.54mm_Horizontal
J2: USB-C; USB-C_Breakout
J3: DB-9_RS232_DTE; DSUB-9_Pins_Horizontal_P2.77x2.84mm_EdgePinOffset7.70mm_Hou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
J4: FTDI_USB; PinHeader_1x06_P2.54mm_Vertical
J5: USB Cable; JST_PH_B5B-PH-K_1x05_P2.00mm_Vertical
Q1: BF545B; SOT-23
Q2, Q3, Q4, Q5: BSS138; SOT-23
R1, R2: 1K; R_0603_1608Metric_Pad0.98x0.95mm_HandSolder
R3, R4, R5, R6, R7, R8, R9, R10: 10K; R_0603_1608Metric_Pad0.98x0.95mm_HandSolder
SW2: Switch; SW_PB_Wurth_5x4mm
U1: 74xx165; SOIC-16_3.9x9.9mm_P1.27mm
U2: 74xx595; SOIC-16_3.9x9.9mm_P1.27mm
U3: 74xx04; SOIC-14_3.9x8.7mm_P1.27mm
U4: MAX3232; SOIC-16_3.9x9.9mm_P1.27mm
U5: 5V Buck Converter
U7: RaspberryPi_Pico; RaspberryPi_Pico_Common_THT

Connections:
3V3: C1.1, C2.1, C3.1, Q2.1 (G), Q3.1 (G), Q4.1 (G), Q5.1 (G), R4.1, R6.1, R8.1, R10.1, SW2.2 (B), U1.16 (VCC), U2.16 (VCC), U3.14 (VCC), U7.36 (3V3)
+5V: C4.1, C10.1, Q1.2 (D), R3.1, R5.1, R7.1, R9.1, U4.16 (VCC), U5.3 (Out+)
+12V: C9.1, J1.25, U5.2 (IN+)
/CTS0: Q5.2 (S), R10.2, U7.24 (GPIO18)
/CTS1: J4.6, U7.5 (GPIO3)
/CTS232: Q5.3 (D), R9.2, U4.9 (R2OUT)
/LED1: D1.2 (A), U7.20 (GPIO15)
/LED2: D2.2 (A), U7.19 (GPIO14)
/MISO: U1.9 (QH), U7.16 (GPIO12)
/MOSI: U2.14 (SER), U7.15 (GPIO11)
/PB1: SW2.1 (A), U7.17 (GPIO13)
/PD0: J1.10, U2.15 (QA)
/PD1: J1.11, U2.1 (QB)
/PD2: J1.12, U2.2 (QC)
/PD3: J1.13, U2.3 (QD)
/PD4: J1.14, U2.4 (QE)
/PD5: J1.15, U2.5 (QF)
/PD6: J1.16, U2.6 (QG)
/PD7: J1.17, U2.7 (QH)
/PunchDataLatch: U2.12 (RCLK), U7.12 (GPIO9)
/PunchReady: U3.6, U7.2 (GPIO1)
/PunchStart: U3.3, U7.1 (GPIO0)
/RD0: J1.1, U1.11 (A)
/RD1: J1.2 (RD1), U1.12 (B)
/RD2: J1.3, U1.13 (C)
/RD3: J1.4, U1.14 (D)
/RD4: J1.5, U1.3 (E)
/RD5: J1.6, U1.4 (F)
/RD6: J1.7, U1.5 (G)
/RD7: J1.8, U1.6 (H)
/RS232_CTS: J3.8, U4.8 (R2IN)
/RS232_RTS: J3.7, U4.7 (T2OUT)
/RS232_RxD: J3.2, U4.13 (R1IN)
/RS232_TxD: J3.3, U4.14 (T1OUT)
/RTS0: Q4.2 (S), R8.2, U7.25 (GPIO19)
/RTS1: J4.2, U7.4 (GPIO2)
/RTS232: Q4.3 (D), R7.2, U4.10 (T2IN)
/ReadDataLoad: U3.13, U7.11 (GPIO8)
/ReaderReady: U3.8, U7.9 (GPIO6)
/ReaderStart: U3.11, U7.10 (GPIO7)
/Rx0: Q3.2 (S), R6.2, U7.22 (GPIO17)
/Rx1: J4.4, U7.7 (GPIO5)
/Rx232: Q3.3 (D), R5.2, U4.12 (R1OUT)
/SCK: U1.2 (CLK), U2.11 (SRCLK), U7.14 (GPIO10)
/Tx0: Q2.2 (S), R4.2, U7.21 (GPIO16)
/Tx1: J4.5, U7.6 (GPIO4)
/Tx232: Q2.3 (D), R3.2, U4.11 (T1IN)
/VBUS: Q1.3 (G), U7.40 (VBUS)
/VSYS: Q1.1 (S), U7.39 (VSYS)
/~H10PunchReady: J1.22, U3.5
/~H10PunchStart: J1.23, U3.4
/~H10ReaderReady: J1.19, U3.9
/~H10ReaderStart: J1.20, U3.10
/~ReadDataLoad: U1.1 (SH/~LD), U3.12
GND: C1.2, C2.2, C3.2, C4.2, C7.2, C8.1, C9.2, C10.2, J1.9, J1.18 (GND2), J1.21, J1.24, J2.2 (GND), J3.5, J4.1, J5.4, R1.1, R2.1, U1.8 (GND), U1.15 (CLK_INH), U2.8 (GND), U2.10 (~SRCLR), U2.13 (~OE), U3.1, U3.7 (GND), U4.15 (GND), U5.1 (IN-), U5.4 (Out-), U7.3 (GND), U7.8 (GND), U7.13 (GND), U7.18 (GND), U7.23 (GND), U7.28 (GND), U7.33 (AGND), U7.38 (GND), U7.42 (GND)
unnamed: D1.1 (K), R1.2
unnamed: D2.1 (K), R2.2
unnamed: J2.5 (D+), J5.3
unnamed: J2.4 (D-), J5.2
unnamed: J2.1 (VBUS), J5.1
unnamed: C5.1, U4.1 (C1+)
unnamed: C5.2, U4.3 (C1-)
unnamed: C6.1, U4.4 (C2+)
unnamed: C6.2, U4.5 (C2-)
unnamed: C7.1, U4.2 (V+)
unnamed: C8.2, U4.6 (V-)

Notes on the sheet:
Reader Data
Punch Control 1. Wait for PunchReady ON 2. Write output data 3. Pulse PunchStart ON for 25 Sec 4. PunchReady will turn OFF within 200 nSec 5. Wait for PunchRead to turn ON
RS232 DTE Interface
Punch Data
Reader Control 1. Wait for ReaderReady OFF 2. Set ReadyStart ON 3. Wait for ReaderReady ON 3. Read Reader data 4. Set ReaderStart OFF 5. Wait for ReaderReady OFF
FTDI Cable
H10 Connector DB-25 Cable

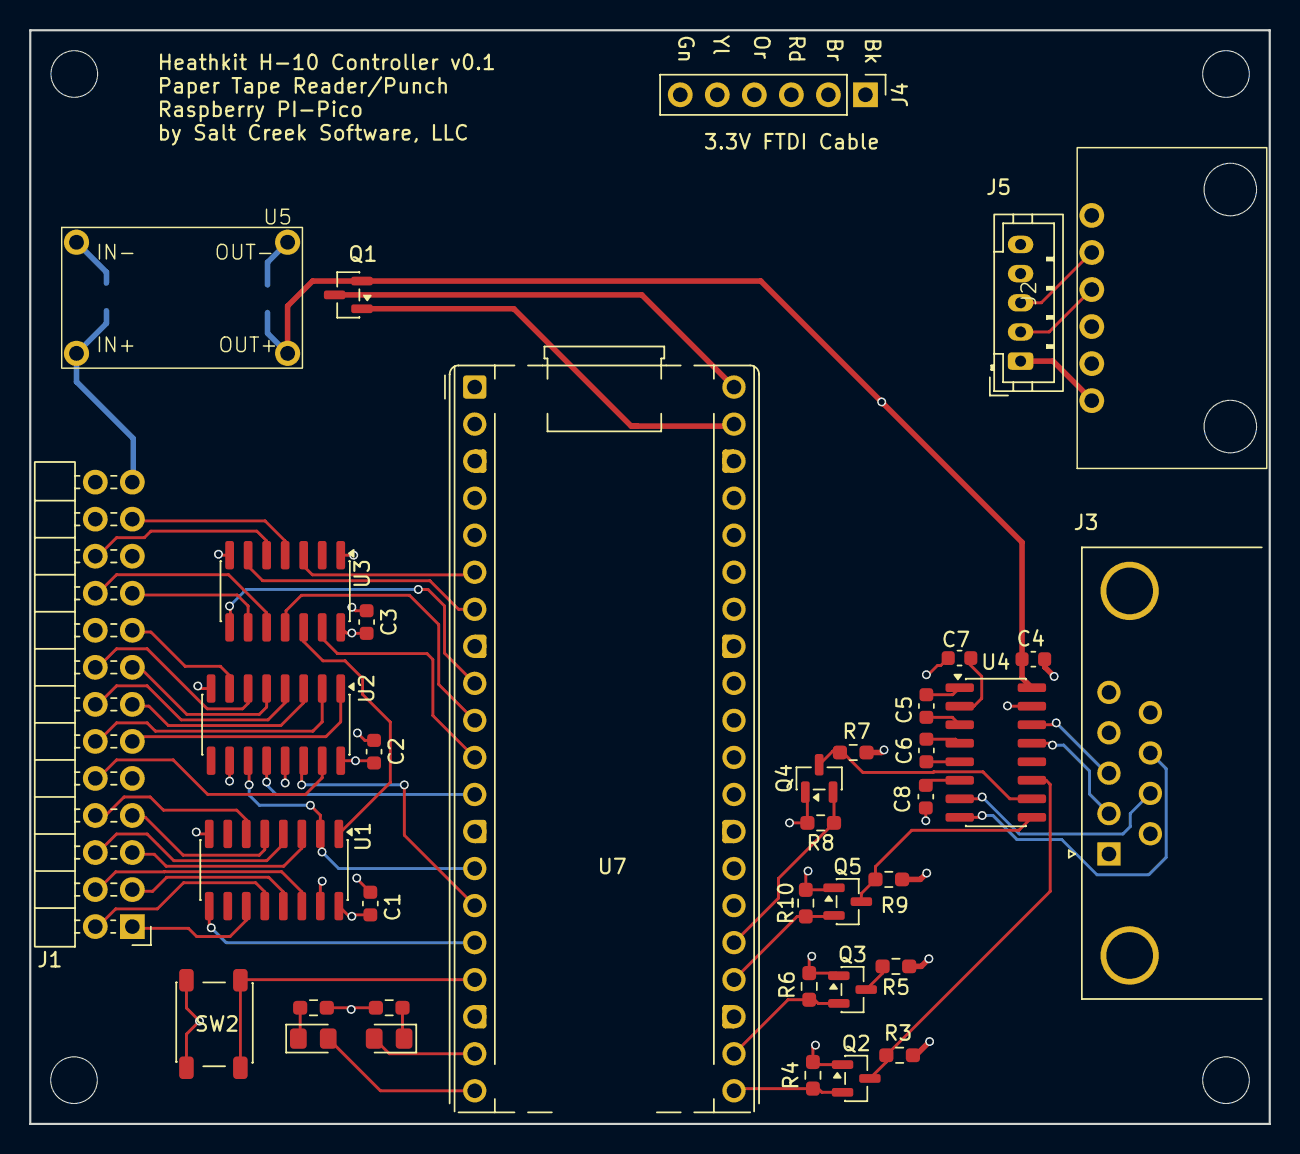
[picture p15: board H10 Pi Pico.kicad_pcb from above]

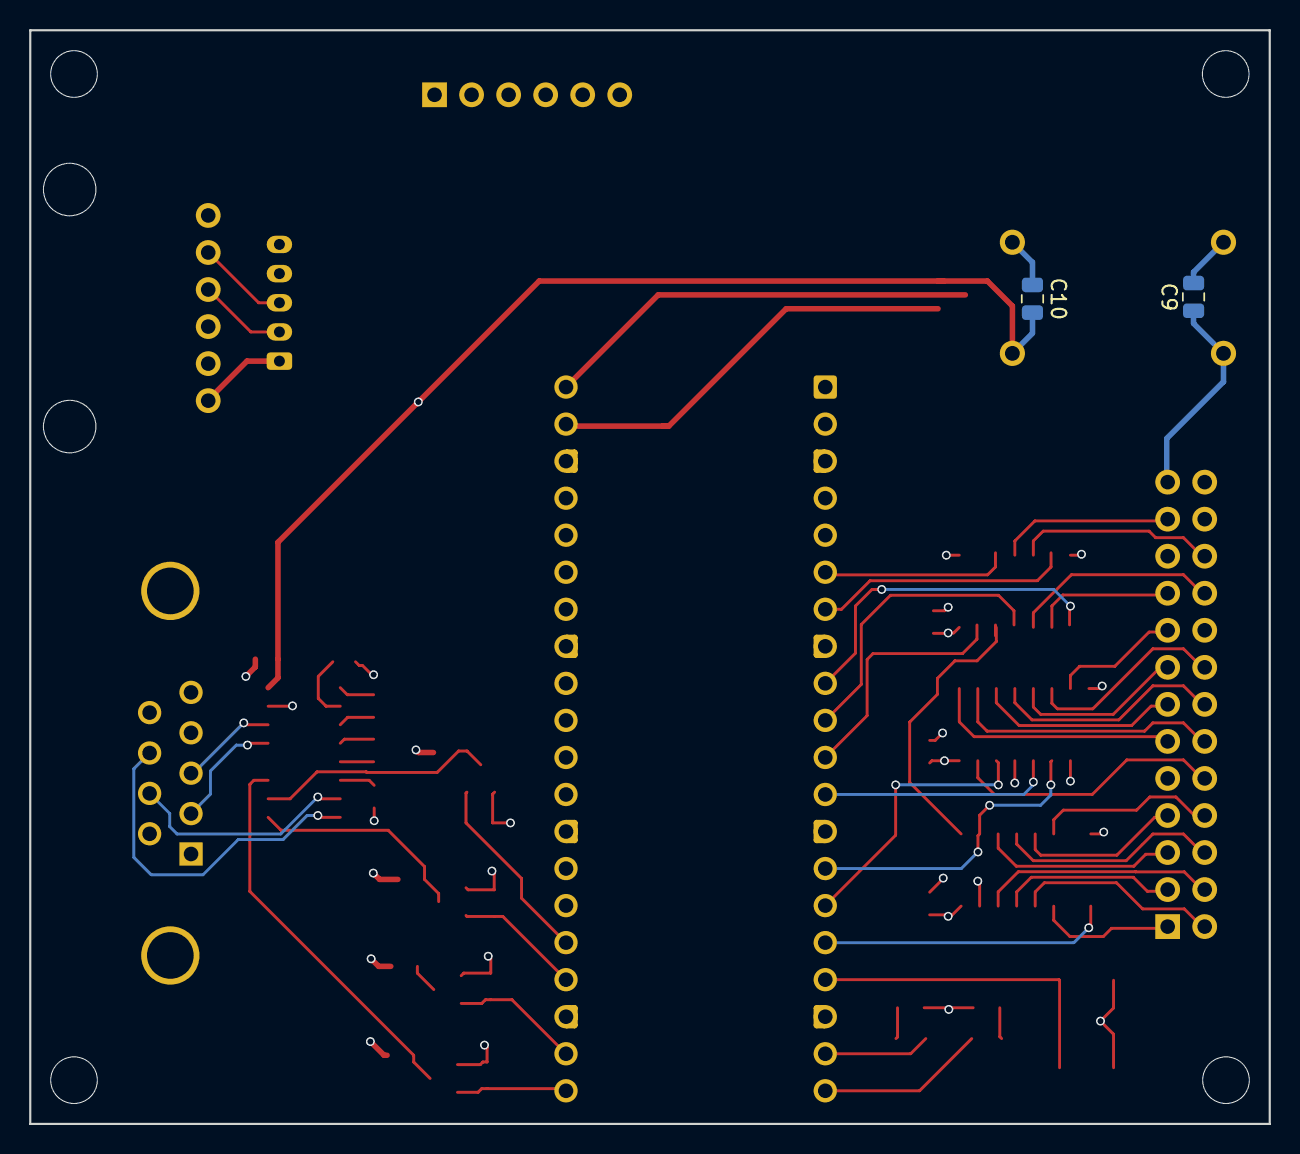
[picture p16: board H10 Pi Pico.kicad_pcb from below]

Board: 4 copper layers, 85.0 x 75.0 mm, 43 parts (2 on the bottom side), 66 nets.
