tlsystems/H10-Paper-Tape-Reader-Punch/(commit log)

2026-03-19 Initial Pico Controller commit
2026-03-19 Initial commit of H10 Controller and H10 Simulator board Kicad projects
    [H10 Pi Pico.kicad_pcb, H10 Pi Pico.kicad_sch, H10 Pico Info.xlsx, H10 Simulator.kicad_pcb, H10 Simulator.kicad_sch]
2026-03-19 Rename gerber zip file
2026-03-19 Add gerbers directory to ignore list
2026-03-20 Flip J1 and J3 to back of board, add labels to J2, bump to v0.2
    [H10 Simulator.kicad_pcb, H10 Simulator.kicad_sch]
2026-03-24 Add Kicad H10-Breakout project
    [H10-Breakout.kicad_pcb, H10-Breakout.kicad_sch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]
2026-03-25 Add Teensy 4.1 version of H10 project to repository
